Harrishao/mechanic-design/README.md

# 一个存作业的自用仓库，如果你误入了这里，那祝你每天都有好心情

# 希望明天也是个好天气
