Harrishao/mechanic-design/设计文档/说明书结构参考.md

# 封面

# 目录

# 第一章 机构运动原理

- 论述机构的原理和各机构工作时的运动流程
- 依据当前方案重绘 重建方案\参考图_整机布局.png 并插入此节

# 第二章 设计要求及机构选型

- 列出题目给出的设计要求，具体内容参照 机械原理课程设计任务书\1.机械原理课程设计任务书（15吨压片机）.doc ，包含具体数据
- 解析设计要求，分析如何设计机构以达到要求
- 讲解构型选择和数据确定的相关内容
- 论述最终确定三个凸轮串联在主轴上，由主轴直接驱动的方案的理由

# 第三章 机构综合

## 下冲头

- 描述下冲头的运动过程，包括具体参数
- 绘制下冲头位移运动循环图，插入
- 绘制下冲头运动简图，插入
- 描述据运动过程推导各构件参数的过程
- 由 凸轮廓线\下冲头凸轮.csv 拟合下凸轮廓线图，插入
- 插入下凸轮3d模型等轴测示意图 图表\下冲头凸轮-3d-等轴测.png
- 插入下冲头3d模型等轴测示意图 图表\下冲头-3d-等轴测.png

## 上冲头

- 描述下冲头的运动过程，包括具体参数
- 绘制下冲头位移运动循环图，插入
- 绘制下冲头运动简图，插入
- 描述据运动过程推导各构件参数的过程
- 由 凸轮廓线\上冲头凸轮v2.csv 拟合下凸轮廓线图，插入
- 插入上凸轮3d模型等轴测示意图 图表\上冲头凸轮-3d-等轴测.png
- 插入上冲头3d模型等轴测示意图 图表\上冲头-3d-等轴测.png

## 粉筛

- 描述与绘图同上
- 插入 图表\粉筛凸轮-3d-等轴测.png
- 插入 图表\粉筛托架-3d-等轴测.png

## 电机及减速器

- 描述根据电机参数选定 Y113m-6 电机的过程，其中提到电机模型来自 https://www.traceparts.com/en/product/hoyer-ie3-electric-motor-frame-size-112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 
- 描述推导减速器齿轮系所用齿轮及带轮参数的过程
- 绘制减速器主体齿轮的运动简图，插入
- 插入图表\电机及减速器-3d.png

## 第四章 整机装配

- 插入 图表\整机初相位-3d.png
- 根据当前数据重绘 图表\运动循环图_细化.png ，插入
- 并作配套说明

## 第五章 上冲头机构运动分析

- 参照 运动分析 目录下内容，其中机构运动简图使用机器绘制的而非手绘图

## 第六章 整机三维图

- 插入 图表\整机装配-3d-侧视.png
- 插入 图表\整机装配-3d-等轴测.png
