Harrishao/mechanic-design/待办事项2.md

# 现在的情况？

- 设计文档\15吨压片机设计计算说明书.docx 的排版和内容并不令人满意
- reference\15T压片机说明书.pdf 是一份好的说明书，以此为格式及内容的参照，重写说明书

# 我们的说明书？

- 结构见 设计文档\说明书结构参考.md

## 需要补充说明的？

- 运动简图的绘制原则：参考 reference\15T压片机说明书.pdf 中运动机构简图及手绘简图，确保所绘运动简图符合标准，如杆件抽象为直线，啮合齿轮简化为"工"字等
