Harrishao/mechanic-design/重建方案/变更_粉筛v4_销左端Y223.md

# 粉筛 v4 变更单：销在左端、销高回到 Y=223（取代 v3）

> 动机：v3 销高 250（高出主体中心 27）会引入俯仰力矩。v4 把销放回主体中心高 Y=223，
> 同时保留左端、Z=0 对中、双耳双剪的全部优点。
> 实现关键：连杆改为与销同高的**短水平连杆**（贴台面上方 5.5 掠过），摆杆连杆臂改为**长竖臂**，
> B 点近水平摆动——连杆既不下穿台面（v2 的 Z 偏置原因）也无需抬高销（v3 的原因）。
> 配套：参考图_托架视图_v4.png · 参考图_粉筛机构_v4.png · 粉筛凸轮v4_SW.txt / .csv · 粉筛v4_左端销223.py · 绘图v4.py

## 1. 不变项

托架本体与筛口、托架运动（−27~+28 / −75~−20，行程48）、运动循环、滚子 d20×15、Z=132.5 站位、上下冲头全部。

## 2. 构件清单（相对 v2 原始方案）

| 构件 | v4 值 |
|---|---|
| 托架 | 左端双耳叉：两耳板 27(X)×8(Z)×14(Y)，与本体同高（Y216~230），Z=±8~±16（内档16），端部R7；销孔 φ8 轴心距左端面 20、**Y=223（主体中心高）** |
| 销 | φ8×约40，沿 Z，双剪；装料位轴心 (−47, 223) |
| 连杆 | **Ls=36.03**（短水平连杆，运动平面 Z=0，距台面最小 5.5） |
| 摆杆 | 滚子臂 Lr=50（滚子沿用）；连杆臂 **Rb=190（竖直向上）**；两臂夹角 **153.91°**；摆角 14.51° |
| 机架支点 O2s | **(−107, 33)**，中心距 a=111.97 |
| 粉筛凸轮 v4 | **r0=80，实际廓线 70.0~82.0**（历版最小），宽20；廓线文件 粉筛凸轮v4_SW.txt |
| 台面 | 左缘 X=−80（窗口 −83~−76：竖臂过台面平面处 X=−83.7，托架支撑需到 −75）；台面上方 Y216~230、X −131~−47、Z±16 范围为连杆/B销运动空间，不得布置挡板或导轨凸起 |

## 3. 装配坐标（装料位 φ=0~90 → 左停位 φ=135~290）

| 点 | 装料位 | 左停位 |
|---|---|---|
| O2s（固定） | (−107, 33) | 同 |
| B 竖臂顶端 | (−83.00, 221.48) | (−131.00, 221.48) |
| C 托架销 | (−47, 223) | (−95, 223) |
| P 滚子中心 | (−90.86, −14.32)，距主轴 **91.98** | (−79.52, −8.77)，距主轴 **80.00**（基圆） |

摆杆方位（自 O2s）：连杆臂 装料 82.74° / 左停 97.26°；滚子臂 左停 −56.66°。

## 4. 校核

行程数值解 48.0000；推卸压力角 **26.4° ≤30°**，左退 37.6°（空程，弹簧力封闭）；最小曲率半径 36.3 ≫ 滚子10；传动角 min **80.3°**；连杆/B 销全程高于台面 5.5；竖臂穿台面平面处 X=−83.7，距台面左缘 3.7；滚子臂段距主轴最小 80 > 下冲头凸轮 64；耳板最右 X=−40 < −17，全程不入冲头区。凸轮为历版最小（实际最大 82.0；v2 89.1 / v3 96.4）。

## 5. 装配与相位

凸轮 v4 廓线按装料位（φ=0，全升程）姿态生成，按零件原始姿态装轴（基准面对齐法同前）。
复核值：**v4 远休弧中点方向 156.5°**（下冲头 145.3°、上冲头 107.8° 不变）。
静态验证：左停位滚子中心距主轴 80.00、销 X=−95；装料位 91.98、销 X=−47。力封闭弹簧保留（可挂竖臂与机架之间，水平拉向 +X）。

> v3（销高250）方案文件保留备查，建模请按本 v4 执行。
