Harrishao/mechanic-design/重建方案/重建数据_上冲头与粉筛.md

# 上冲头 / 粉筛机构 重建数据（v2）

> 配套文件（均在 `重建方案/` 内）：
> 参考图_上冲头机构.png · 参考图_粉筛机构.png · 参考图_凸轮工作图.png · 参考图_运动与压力角.png · 参考图_整机布局.png · 参考图_托架视图.png
> 上冲头凸轮v2_SW.txt / .csv · 粉筛凸轮v2_SW.txt / .csv · 计算脚本.py · 绘图脚本.py · 结果.json
> 所有数据由 计算脚本.py 解析计算并经数值反验（廓线-滚子接触偏差 < 0.001mm），单位 mm / 度。

---

## 0. 基准约定（与下冲头完全一致，不变）

- 凸轮回转中心 O1 = (0,0)，主轴沿 Z，**逆时针**回转（已从 下冲头凸轮_SW.txt 反推确认）
- φ = 0 为装填位；型腔轴线 X = 0；型腔顶面 Y = 216、底面 Y = 186（φ34×30，不变）
- 台面 Y = 216；下冲头机构、下冲头凸轮、型腔、运动循环中下冲头相位**全部不变**
- 凸轮轴向站位不变：下冲头中面 Z = 0 / 上冲头 Z = 67.5 / 粉筛 Z = 132.5；轮缘宽 25 / 30 / 20
- 滚子沿用现有件：上冲头滚子 d24×15、粉筛滚子 d20×15

## 1. 重建要点（相对旧方案的改变）

1. **上冲头改为二级摆杆增力布置**（按手绘方案页面下方画法）：凸轮 → 下摆杆（O2）→ 长连杆 → 上摆杆（O3，直杆杠杆，臂比 70:140 = 1:2）→ 小连杆 → 冲头。摆杆需求摆角由 30° 降到 18.2°，凸轮理论基圆由 **117 → 54**，实际廓线最大半径仅 68.9；冲头长度由 231 → **130**。
2. **粉筛同拓扑缩小**：中心距 170 → **109.7**，理论基圆 113.5 → **81**，实际廓线最大半径 89.1（旧方案仅基圆就 113.5）；连杆 250 → 211.7。托架、筛口、耳板销位**不变**（销 Y=223，行程仍 48，装料位销 X=+42、筛口中心对正 X=0）。
3. **粉筛左退窗口由 90~120° 放宽到 90~135°**，以压低左退压力角。校核依据：上冲头尖端在 φ≈170° 才降到托架顶面高度（Y≈230），φ=135 退净仍有 35° 裕量；其余相位不动。⚠ 需同步更新 运动循环图 与运动方案文档中粉筛一行。
4. 两机构全部杆系位于 XY 平面（Z≈0 薄层），仅滚子沿 Z 悬臂伸至各自凸轮站位（沿用现有"z轴避让"做法）；**粉筛连杆与托架耳板置于 Z≈+45 平面**（托架前缘侧），与冲头错开。
5. 旧 整机装配参数填写表.md 中上冲头、粉筛两节作废，以本文档为准。

## 2. 运动循环（重建后，主轴转角 φ，25 r/min）

| φ (°) | 0–90 | 90–120 | 120–135 | 135–200 | 200–240 | 240–290 | 290–335 | 335–360 |
|---|---|---|---|---|---|---|---|---|
| 上冲头(尖端Y) | 300 停 | 300 停 | 300 停(至120) | 120–200 摆线下压至 205 | 205 保压 | 摆线回 300 | 300 停 | 300 停 |
| 下冲头 | 不变 | 下沉 | 复位+预压(不变) | 不变 | 保压(不变) | 顶出(不变) | 停(不变) | 复位(不变) |
| 粉筛(销X) | +42 停(筛料) | 90–135 摆线左退至 −6 | ← | −6 停 | −6 停 | −6 停 | 摆线右移推卸至 +42 | +42 停 |

位移过渡均为摆线（等同旧方案），凸轮廓线即按上表生成。

## 3. 上冲头机构（建模数据）

### 3.1 机构简述

凸轮（O1）推下摆杆（支点 O2，滚子臂 Lr、连杆臂 LB）；B 点经长连杆 L1 上传至上摆杆 D 端；上摆杆为**直杆杠杆**（支点 O3，D 臂 70 / C 臂 140，两臂反向共线）；C 端经小连杆 L2 下挂冲头销 E；冲头沿 X=0 竖直导向。压程中凸轮升程将冲头压下，行程精确 95。

### 3.2 构件尺寸

| 构件 | 参数 | 数值 |
|---|---|---|
| 凸轮 v2 | 理论基圆 r0 / 实际廓线半径 / 轮缘宽 / 孔径 | 54 / 42.0~68.9 / 30 / φ20 |
| 滚子（沿用） | 直径 × 宽 | d24 × 15 |
| 下摆杆 | 滚子臂 Lr / 连杆臂 LB / 两臂夹角 / 摆角 | 85 / 150 / 121.28° / 18.218° |
| 长连杆 | 孔心距 L1 | **423.93** |
| 上摆杆（直杆） | D 臂 R3 / C 臂 R3p（反向共线，总长 210）/ 总转角 | 70 / 140 / 39.67° |
| 小连杆 | 孔心距 L2 | 75 |
| 上冲头 | 销 E→尖端 Lp / 工作端 / 导向段 | **130** / φ34×45 / φ40×85 |

### 3.3 装配坐标（装填位 φ=0 → 保压位 φ=200~240）

| 点 | 装填位 (X,Y) | 保压位 (X,Y) | 说明 |
|---|---|---|---|
| O1 | (0, 0) | 同 | 主轴，固定 |
| O2 | (100, 35) | 同 | 下摆杆支点，固定，机架 |
| O3 | (140, 457.04) | 同 | 上摆杆支点，固定，机架 |
| P 滚子中心 | (45.02, −29.82) | (68.04, −43.76) | 装填位方位角 −33.5° |
| B | (248.14, 11.47) | (248.07, 58.97) | 下摆杆连杆臂端 |
| D | (205.85, 433.29) | (205.85, 480.79) | 上摆杆短臂端 |
| C | (8.30, 504.54) | (8.30, 409.54) | 上摆杆长臂端 |
| E 冲头销 | (0, 430.00) | (0, 335.00) | 冲头尖端 = E_y − 130 |
| 冲头尖端 | (0, 300.00) | (0, 205.00) | 行程 95.000 |

导向套建议：φ40 内孔，沿 X=0 布置在 Y ≈ 308~358（保压位仍有 ≥27 导向长度）。
下摆杆装填位姿态：连杆臂方位 −9.02°、滚子臂方位 −130.30°（自 O2，从 +X 轴逆时针计）。

### 3.4 校核结果

- 压力角：压程（120~200°）max = **29.9° ≤ 30°**；回程（240~290°，空程）max = 44.0°（建议在 E 或 D 处加复位拉簧力封闭，弹簧只需克服构件自重与摩擦）
- 传动角：长连杆-下摆杆 min 75.3°，长连杆-上摆杆 min 64.4°；小连杆最大偏摆 6.4°（冲头侧向力 ≤ tan6.4° ≈ 11% 压力，可接受）
- 节曲线最小曲率半径 23.0 > 滚子半径 12，无根切
- 行程数值解 95.0000；保压段（200~240°）冲头位移恒为 95，与下冲头保压相位完全重合

## 4. 粉筛机构（建模数据）

### 4.1 机构简述

凸轮（O1）推摆杆（支点 O2s，滚子臂 50、连杆臂 110）；B 点经连杆 Ls 推托架销 C 沿台面（Y=216）水平滑动。基圆段对应左停位；升程（推卸 290~335°）凸轮主动推托架右移推走药片并回到装料位，受力方向合理。

### 4.2 构件尺寸

| 构件 | 参数 | 数值 |
|---|---|---|
| 凸轮 v2 | 理论基圆 r0 / 实际廓线半径 / 轮缘宽 / 孔径 | 81 / 71.0~89.1 / 20 / φ20 |
| 滚子（沿用） | 直径 × 宽 | d20 × 15 |
| 摆杆 | 滚子臂 Lr / 连杆臂 Rb / 两臂夹角 / 摆角 | 50 / 110 / 129.77° / 21.132° |
| 连杆 | 孔心距 Ls | **211.71** |
| 托架（不变） | 长×宽×厚 / 筛口 / 销孔位 | 55×60×14 / 36×40 / 销Y=223 |

### 4.3 装配坐标（装料位 φ=0~90 → 左停位 φ=135~290）

| 点 | 装料位 (X,Y) | 左停位 (X,Y) | 说明 |
|---|---|---|---|
| O2s | (−100, −45) | 同 | 摆杆支点，固定，中心距 a=109.66 |
| P 滚子中心 | (−61.88, −77.36) | (−52.78, −61.44) | 装料位=全升程，方位角 −128.7° |
| B | (−98.91, 64.99) | (−138.64, 57.99) | 摆杆连杆臂端 |
| C 托架销 | (42, 223) | (−6, 223) | 行程 48.000；装料位筛口中心 X=0 |

摆杆姿态（自 O2s，从 +X 轴逆时针计）：连杆臂方位 装料位 89.43° / 左停位 110.57°；滚子臂方位 左停位 −19.20°。

### 4.4 校核结果

- 压力角：推卸（工作行程，290~335°）max = **20.8° ≤ 30°**；左退（90~135°，空程）max = 37.0°（弹簧力封闭即可；左退窗口已由 30° 放宽到 45°，否则此值 >55°）
- 传动角：连杆-摆杆 min 41.2°；连杆与水平最大夹角 51.2°（与旧方案 44.5° 相当）
- 节曲线最小曲率半径 34.4 > 滚子半径 10，无根切
- 左停位连杆到主轴最小距离 144.4 > 凸轮最大半径 89.1，无干涉

### 4.5 托架细化尺寸（见 参考图_托架视图.png，装料位基准）

| 要素 | 尺寸 / 位置（装料位） |
|---|---|
| 本体 | 55(X) × 60(Z) × 14(Y)；X −27~+28，Y 216~230，Z −30~+30；前缘(推卸缘) X=+28 |
| 筛口 | 36(X) × 40(Z) 上下通孔；X −18~+18（中心正对型腔 X=0），Z −20~+20；距前缘 10、距后缘 9、Z 向两侧各留 10 |
| 耳板 | 厚 8 平板，平行 XY 平面，Z +41~+49（中面 +45 = 连杆运动平面）；X +8~+49，高 14（Y 216~230），端部 R7 圆头 |
| 连接颈 | 20(X) × 14(Y) × 11(Z)；X +8~+28，Z +30~+41，连接本体前面与耳板 |
| 销孔 | φ8 通孔，轴线沿 Z，轴心 (42, 223)（距下表面 +7 / 距上表面 −7） |
| 位置 | 装料位销 X=+42（φ=0~90°）；左停位整体左移 48，销 X=−6（φ=135~290°） |

## 5. 凸轮廓线文件与安装相位

1. `上冲头凸轮v2_SW.txt`、`粉筛凸轮v2_SW.txt` 为**实际廓线**（已扣滚子半径），格式与 下冲头凸轮_SW.txt 相同（x TAB y TAB 0，闭合，720 点），SolidWorks「通过 XYZ 点的曲线」直接导入后拉伸。
2. 廓线在**真实机构坐标系**中生成：文件姿态即装填位（φ=0）姿态。装配时把主轴置于装填位（下冲头装填位、上冲头最高、粉筛在装料位），三凸轮**按文件原始姿态装上即可，无需再旋转**（即"装填位对齐法"，旧表中 0°/128°/201° 的数值安装角作废）。
3. 校对基准：装填位时上冲头凸轮滚子中心应在方位角 −33.5°、半径 54 处；粉筛凸轮滚子中心在方位角 −128.7°、半径 99.07 处（粉筛装填位为全升程）。
4. `.csv` 含 φ、摆角 ψ、节曲线半径、实际廓线半径、压力角，可用于说明书运动分析章节。

## 6. 建模与装配顺序建议

1. 按 §3.2 / §4.2 建摆杆、连杆、上摆杆（直杆）、缩短后的上冲头；凸轮由 txt 导入拉伸（宽 30 / 20，孔 φ20 + 键槽）。
2. 摆杆滚子臂照旧做 z 向避让：滚子悬臂伸至各自凸轮中面（上冲头 Z=67.5、粉筛 Z=132.5），杆系本体留在 Z≈0 薄层；粉筛连杆与托架耳板在 Z≈+45 平面。
3. 机架需新增三个固定支点：O2(100,35)、O3(140,457.04)、O2s(−100,−45)，及 X=0、Y≈308~358 的冲头导向套。
4. 台面右缘控制在 X ≤ 180（上冲头长连杆运动区 X≈206~248）；左缘照旧给托架让位。
5. 铰点销径沿用现有 d8 / d20 销件体系。
6. 上冲头、粉筛各加一根复位拉簧（力封闭），分别挂在 E/D 附近与摆杆连杆臂上。

## 7. 需同步更新的旧文档

- [ ] 运动循环图（细化）：粉筛左退 90~120 → **90~135**
- [ ] 15吨压片机整机运动方案.docx 粉筛一行同上
- [ ] 整机装配参数填写表.md：§1 安装相位、§3 上冲头、§4 粉筛 作废，改引本文档
- [ ] 删除旧版上冲头摆杆 v1/v2/v3、旧上冲头凸轮、旧粉筛凸轮等模型，避免误用
