Harrishao/mechanic-design/归档_旧版/变更_粉筛v3_销移左端.md

# 粉筛 v3 变更单：托架销移至左端（取代 v2 粉筛部分）

> 动机：v2 耳板悬于前侧（Z=+45）单耳受力且不美观。销移到左端后耳板全程不进入冲头区
> （销最右仅 X=−47 < −17），因此可放回托架中线 Z=0 并做成双耳夹叉——受力过质心、销双剪。
> 配套文件：参考图_托架视图_v3.png · 参考图_粉筛机构_v3.png · 粉筛凸轮v3_SW.txt / .csv · 粉筛v3_左端销.py · 绘图v3.py

## 1. 不变项

托架本体（55×60×14、筛口36×40 及其留边）、托架运动（位置 −27~+28 / −75~−20、行程48、装料位筛口对型腔）、运动循环相位、滚子 d20×15、凸轮轴向站位 Z=132.5、上冲头与下冲头全部。

## 2. 需同步修改的构件（共 6 项）

| 构件 | 改动 | 新值 |
|---|---|---|
| 托架 | 删除右前侧耳板+连接颈；左端加双耳夹叉 | 双耳板 27(X)×8(Z)×39(Y 218~257)，Z=±8~±16（内档16），销孔 φ8 轴心距左端面 20、Y=250，端部 R7；耳板底 Y=218（高出台面2） |
| 销 | 移位并加长（双剪） | φ8×约40，轴线沿 Z，轴心装料位 (−47, 250) |
| 连杆 | 重做（缩短），端头入叉口 | 孔距 **Ls=170.56**，端头厚 ≤14 |
| 摆杆 | 臂长不变、夹角改 → 新零件 | Lr=50 / Rb=110 不变；两臂夹角 **151.36°**（原129.77°）；摆角 17.58° |
| 机架支点 O2s | 移位 | **(−113, 52)**（原 (−100,−45)），中心距 a=124.39 |
| 粉筛凸轮 | 重新生成 v3 | r0=92，实际廓线 82.0~96.4，宽20；导入 粉筛凸轮v3_SW.txt |

另：台面左缘收至 **X=−80**（区间 −86~−76 均可：≥−76 保证托架支撑到 −75，≤−86 之前连杆不穿台面，全行程连杆穿 Y=216 平面最右点为 −87.8）。v2 文档中"粉筛连杆位于 Z≈+45 平面"的注记作废，连杆运动平面改为 **Z=0**。

## 3. 装配坐标（装料位 φ=0~90 → 左停位 φ=135~290）

| 点 | 装料位 | 左停位 |
|---|---|---|
| O2s（固定） | (−113, 52) | 同 |
| B 连杆臂端 | (−177.98, 140.75) | (−201.75, 116.98) |
| C 托架销 | (−47, 250) | (−95, 250) |
| P 滚子中心 | (−106.42, 2.44)，距主轴 99·07→**106.44** | (−91.75, 6.74)，距主轴 **92.00**（基圆） |

摆杆方位（自 O2s）：连杆臂 装料 126.21° / 左停 143.79°；滚子臂 左停 −64.85°。

## 4. 校核

行程数值解 48.0000；推卸压力角 max **28.7° ≤30°**，左退 39.3°（空程，弹簧力封闭）；节曲线最小曲率半径 40.9 ≫ 滚子10；连杆-摆杆传动角 min **86.4°**（v2 为 41.2°，大幅改善）；滚子臂段距主轴最小 92 > 下冲头凸轮最大半径 64；耳板/销全程 X ≤ −40，不进入冲头区（±17）。代价：凸轮略增大（实际最大 96.4，v2 为 89.1）。

## 5. 装配与相位

凸轮 v3 廓线仍按真实坐标、装料位（φ=0，全升程）姿态生成：按零件原始姿态装轴即可（基准面对齐法同前）。复核值更新：**v3 远休弧中点方向 146.2°**（替代 v2 的 198.8°；下冲头 145.3°、上冲头 107.8° 不变），即「粉筛(v3)远休中点 − 下冲头远休中点 = +0.9°」。静态验证：左停位滚子中心距主轴 92.00、销 X=−95；装料位 106.44、销 X=−47。力封闭弹簧保留。
