Harrishao/mechanic-design/交付用/图表/下冲头-3d-等轴测.png

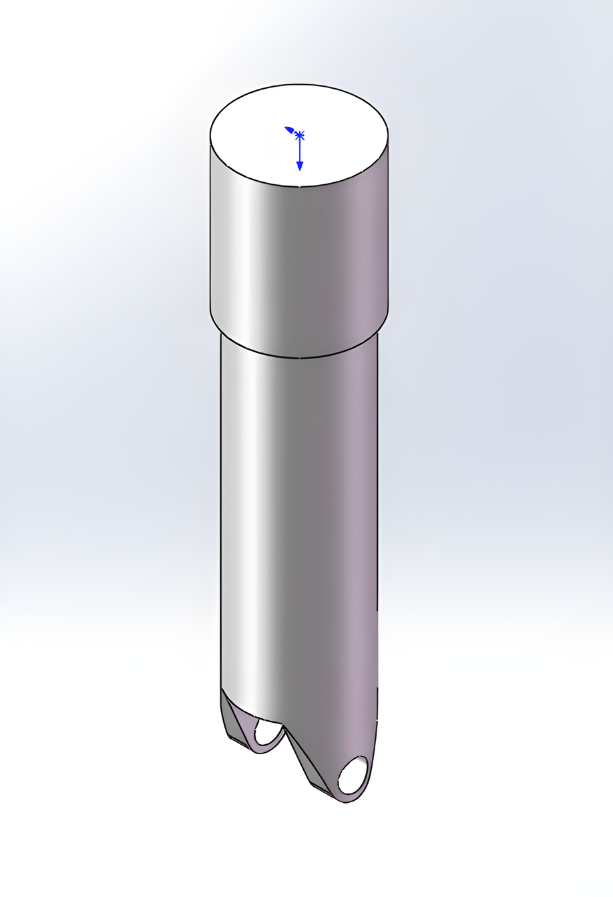
交付用/图表/下冲头-3d-等轴测.png
