Harrishao/mechanic-design/交付用/图表/廓线_上冲头.png

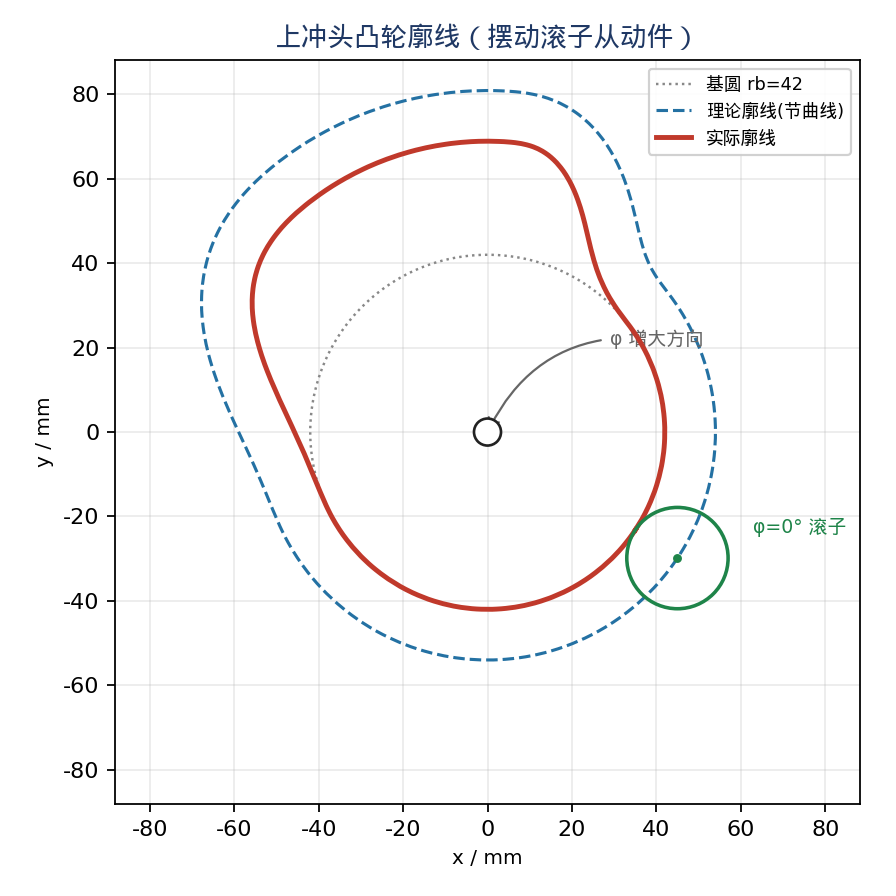
交付用/图表/廓线_上冲头.png
