Harrishao/mechanic-design/交付用/图表/廓线_下冲头.png

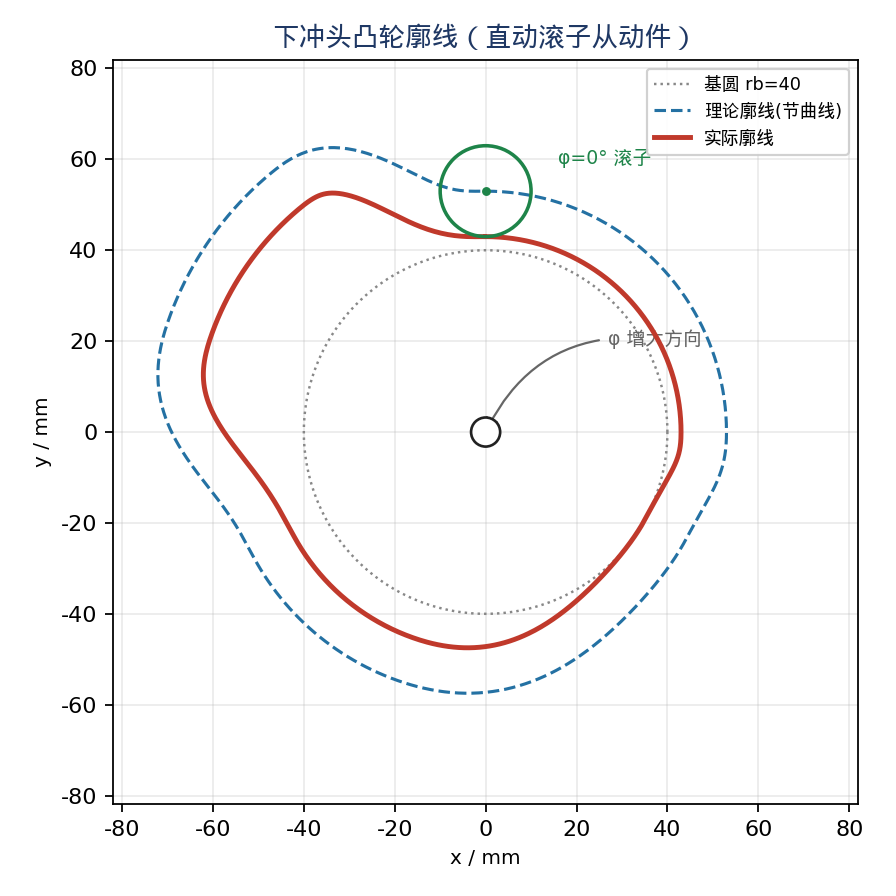
交付用/图表/廓线_下冲头.png
