Harrishao/mechanic-design/交付用/图表/廓线_粉筛.png

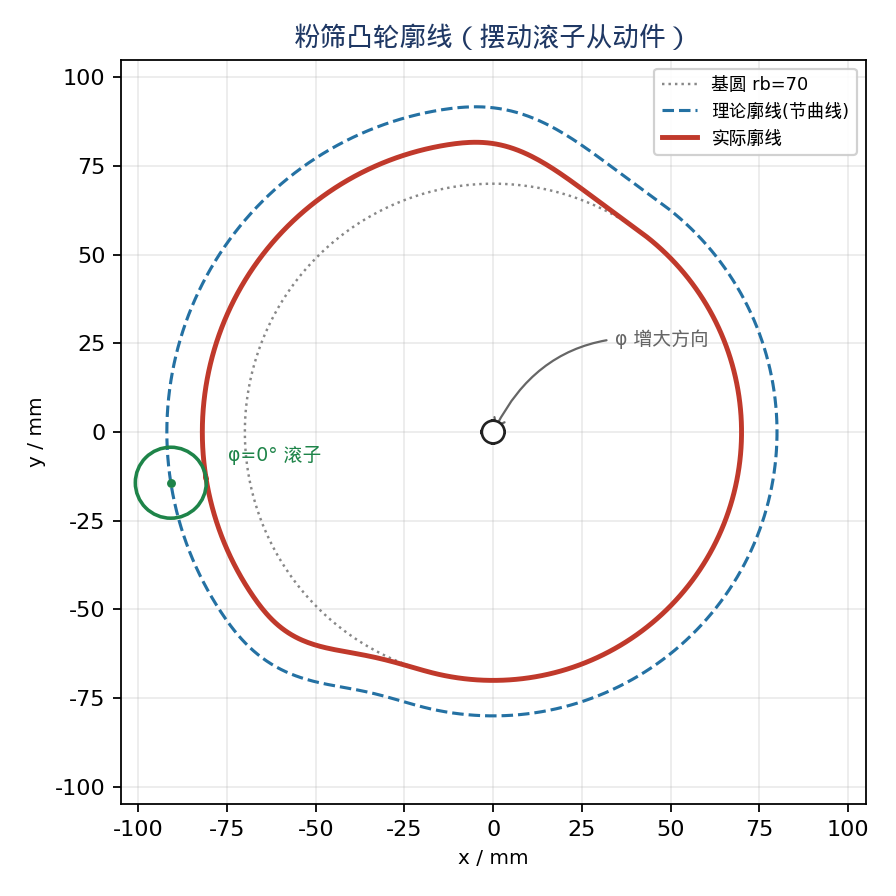
交付用/图表/廓线_粉筛.png
