Harrishao/mechanic-design/交付用/图表/循环_上冲头.png

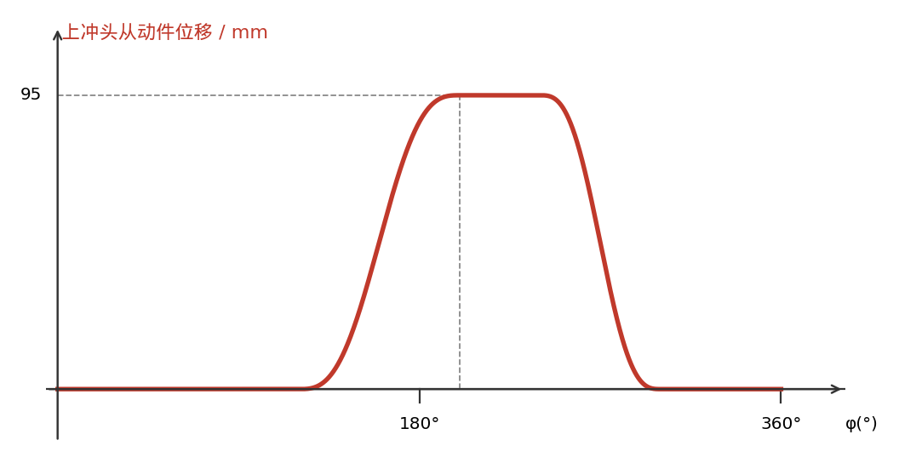
交付用/图表/循环_上冲头.png
