Harrishao/mechanic-design/交付用/图表/循环_下冲头.png

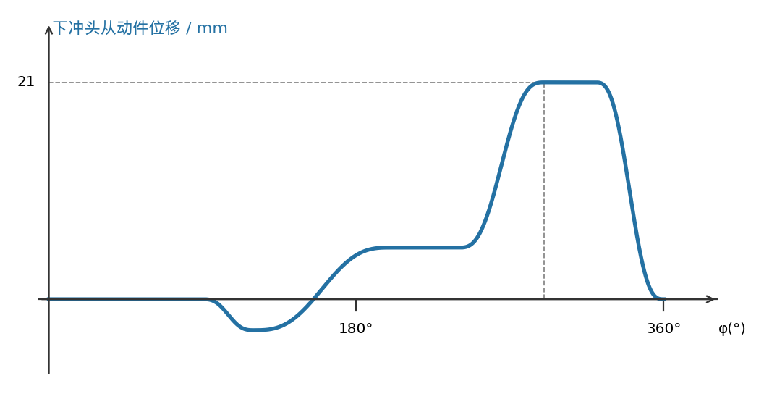
交付用/图表/循环_下冲头.png
