Harrishao/mechanic-design/交付用/图表/循环_粉筛.png

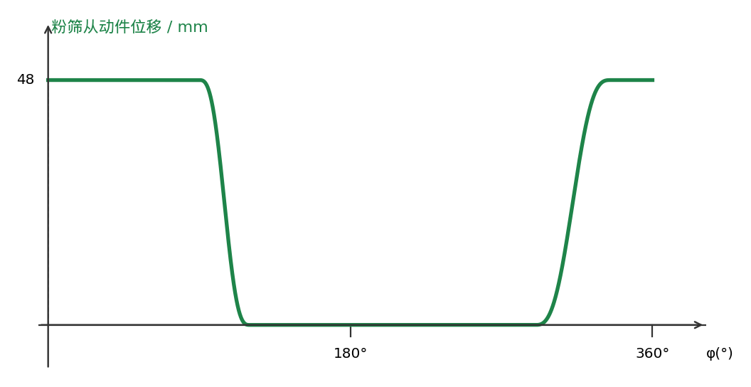
交付用/图表/循环_粉筛.png
