Harrishao/mechanic-design/交付用/图表/整机初相位-3d.png

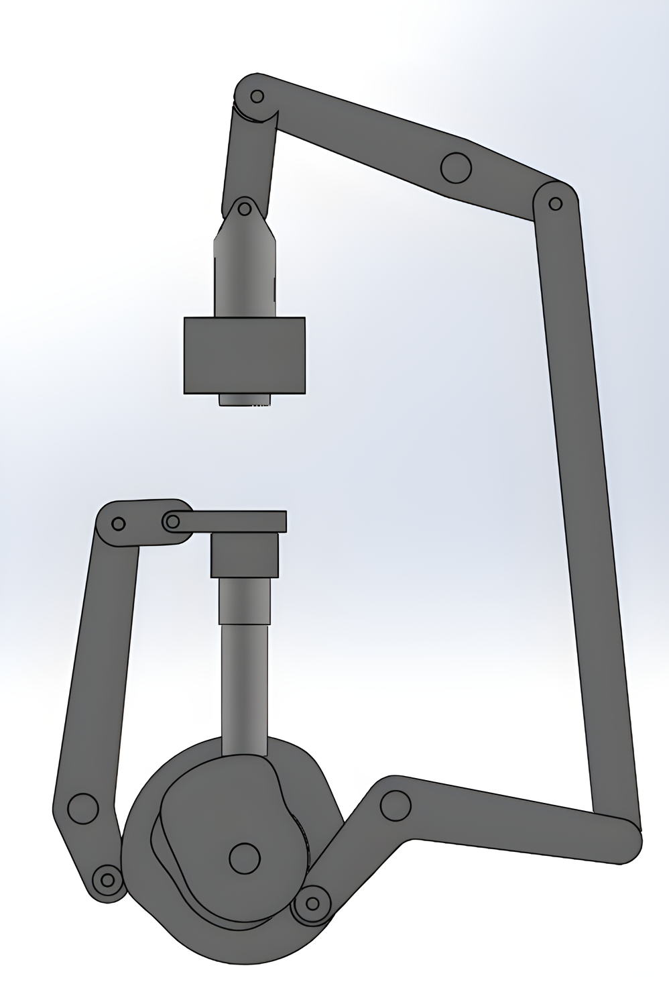
交付用/图表/整机初相位-3d.png
