Harrishao/mechanic-design/交付用/图表/整机机构运动简图.png

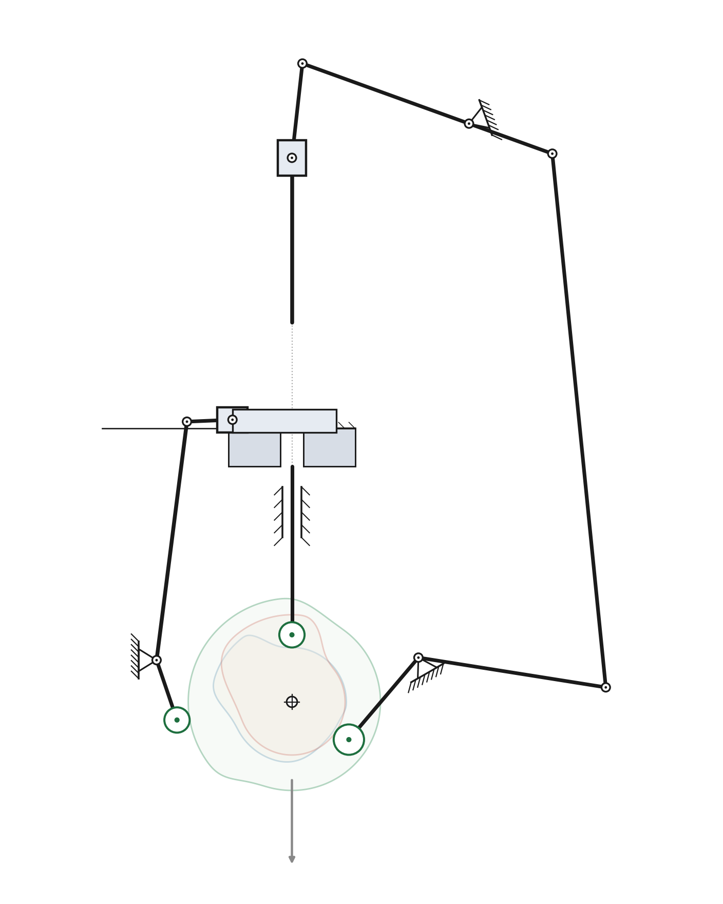
交付用/图表/整机机构运动简图.png
