Harrishao/mechanic-design/交付用/图表/电机及减速器-3d.png

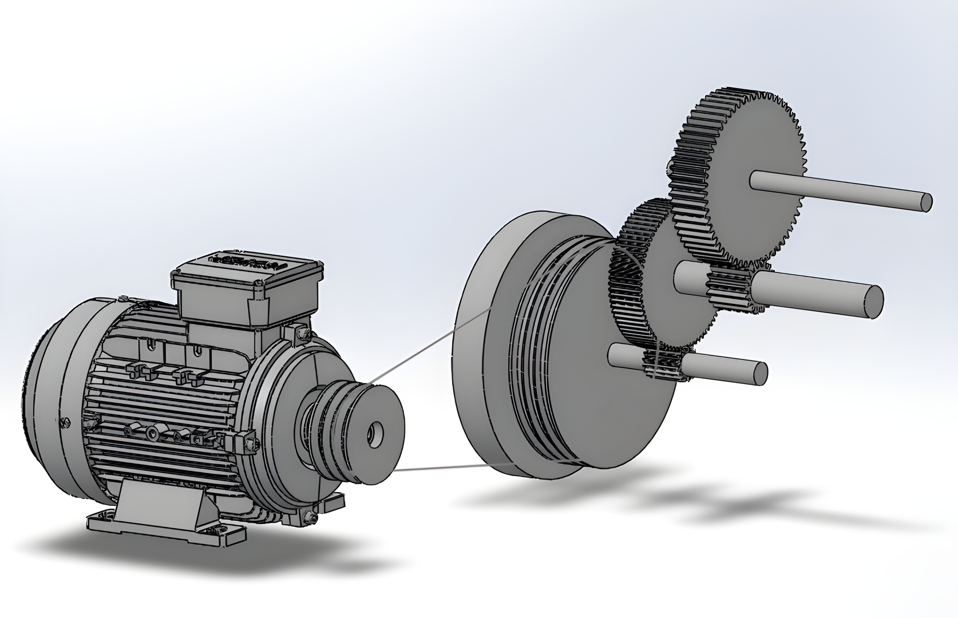
交付用/图表/电机及减速器-3d.png
