Harrishao/mechanic-design/交付用/图表/简图_上冲头.png

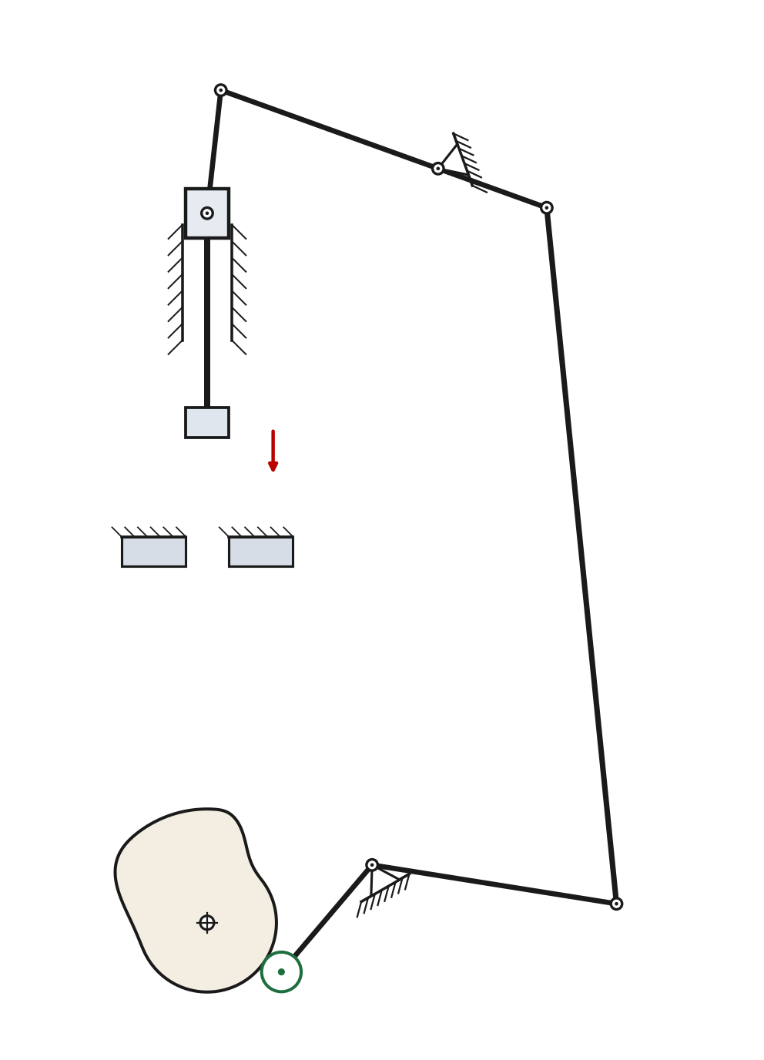
交付用/图表/简图_上冲头.png
