Harrishao/mechanic-design/交付用/图表/简图_减速器.png

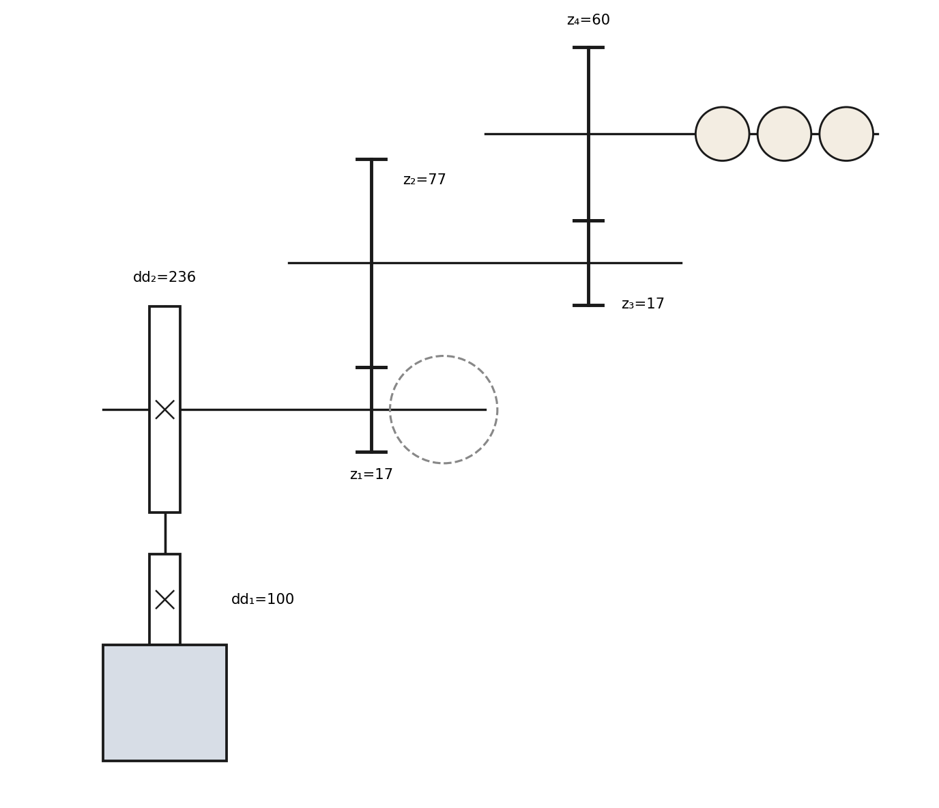
交付用/图表/简图_减速器.png
