Harrishao/mechanic-design/交付用/图表/简图_粉筛.png

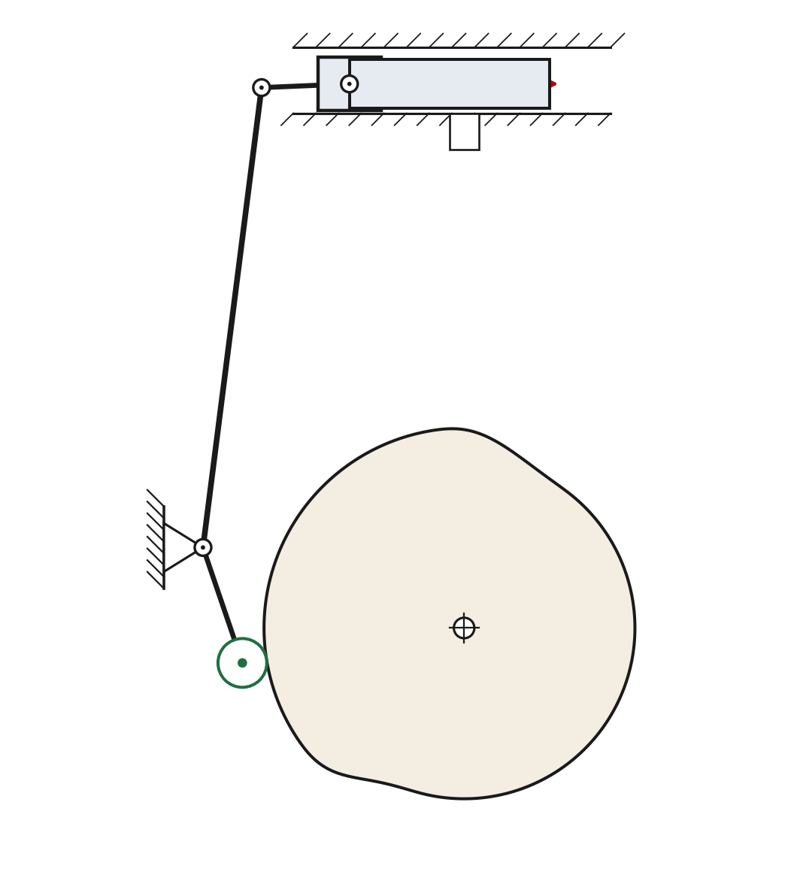
交付用/图表/简图_粉筛.png
