Harrishao/mechanic-design/交付用/图表/粉筛托架-3d-等轴测.png

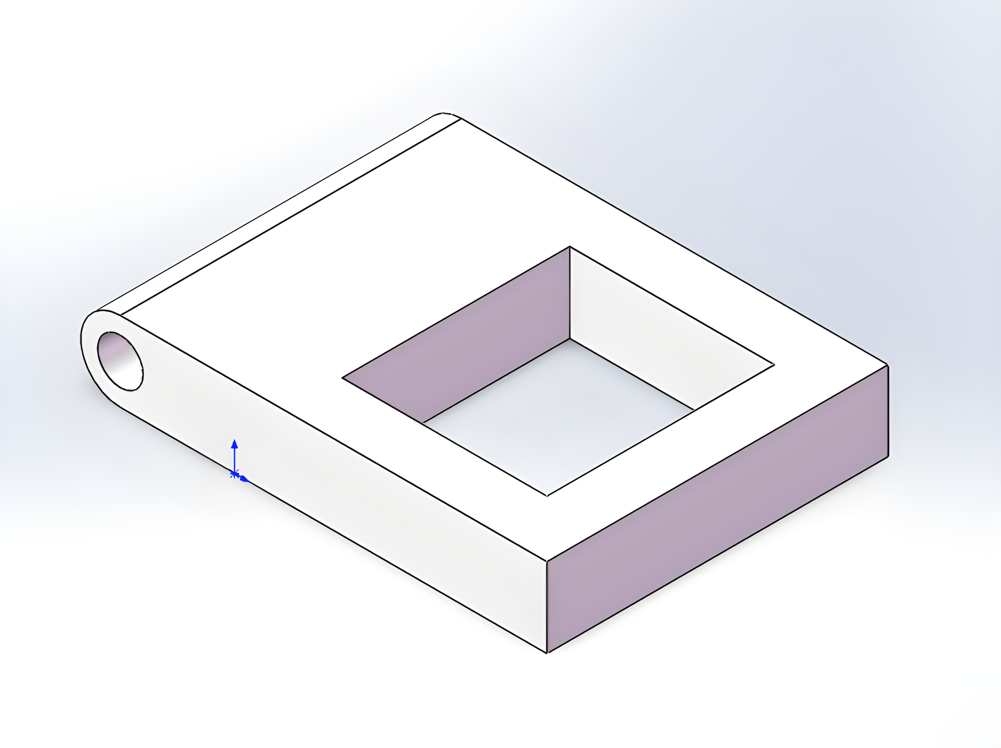
交付用/图表/粉筛托架-3d-等轴测.png
