Harrishao/mechanic-design/图表/新图_待审阅/审阅_运动简图组.jpg

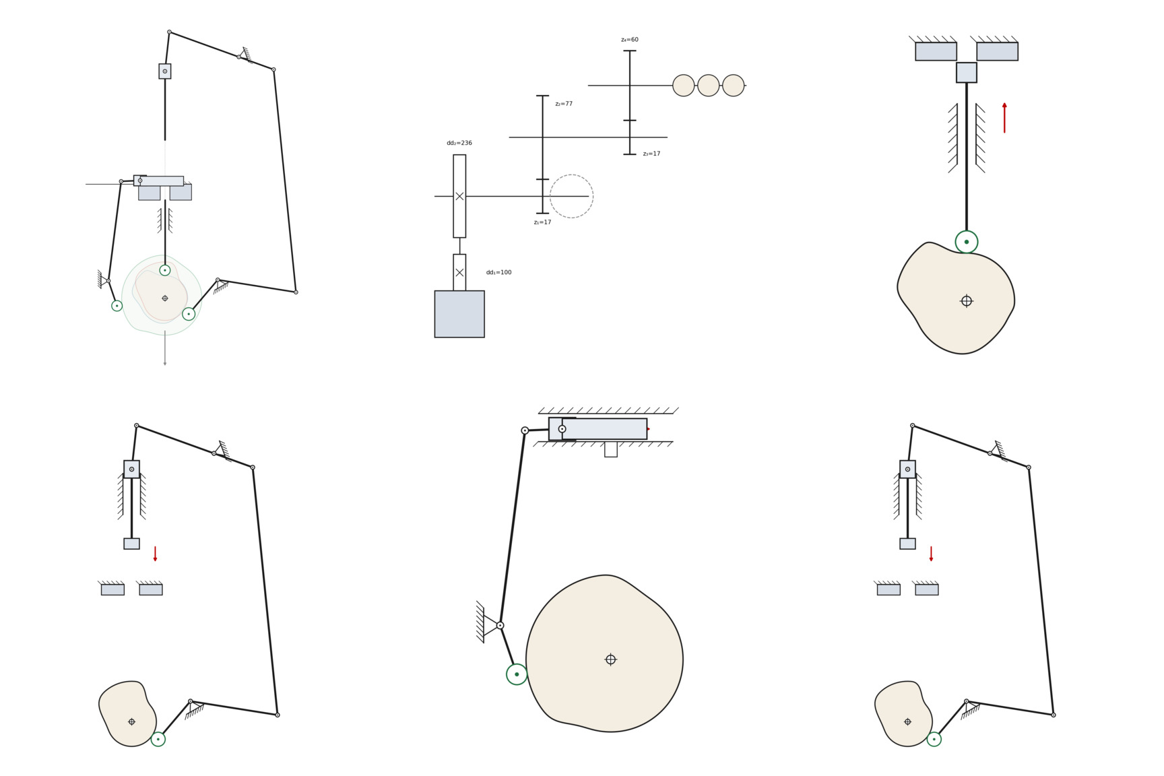
图表/新图_待审阅/审阅_运动简图组.jpg
