Harrishao/mechanic-design/三维模型/整机装配v2.SLDASM

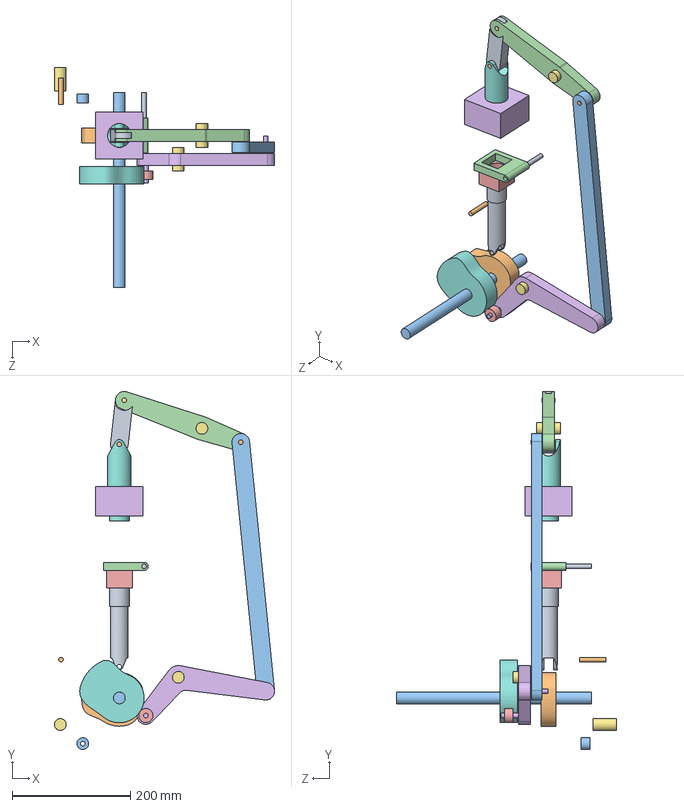
[picture p38: CAD file, 2026-06-12]
三维模型/整机装配v2.SLDASM
373.1 x 606.8 x 372.5 mm
主轴
下冲头凸轮
下冲头
上冲头凸轮v2
d20销 x 3
上冲头下摆杆v2
上冲头滚子
上冲头上摆杆v2
上冲头长连杆v2
d8销l40 x 2
上冲头短连杆v2
上冲头v2
d8销l22
导向套
型腔
粉筛托架
粉筛滚子
d8销l45
d8销l80
