Harrishao/mechanic-design/交付用/三维模型/上冲头-运动分析.SLDASM

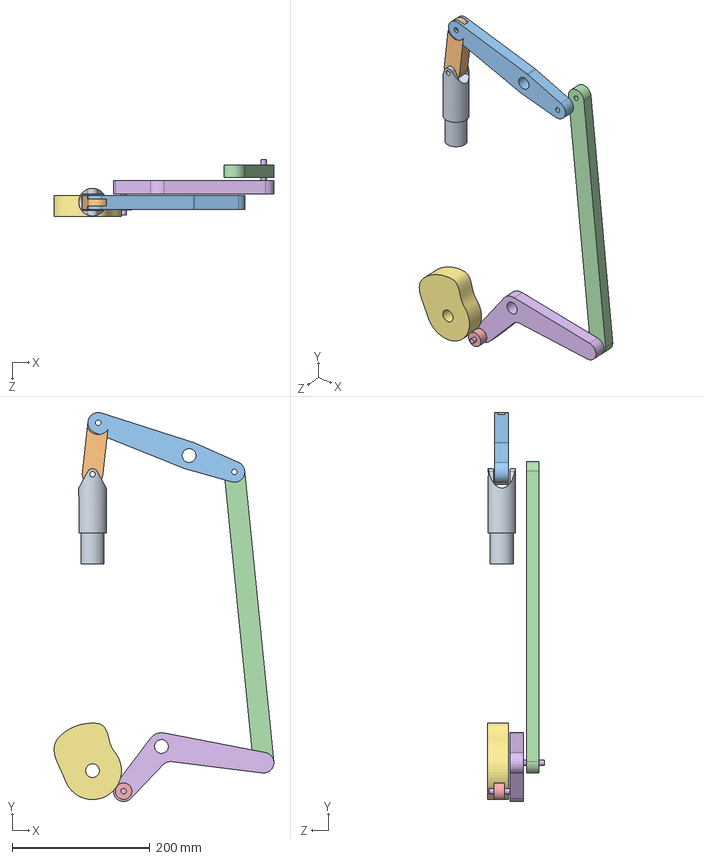
[picture p39: CAD file, 2026-06-14]
交付用/三维模型/上冲头-运动分析.SLDASM
318.8 x 564.2 x 82.0 mm
上冲头凸轮v2
上冲头下摆杆v2
上冲头滚子
上冲头长连杆v2
上冲头上摆杆v2
上冲头短连杆v2
上冲头v2
