Harrishao/mechanic-design/三维模型/上冲头装配.SLDASM

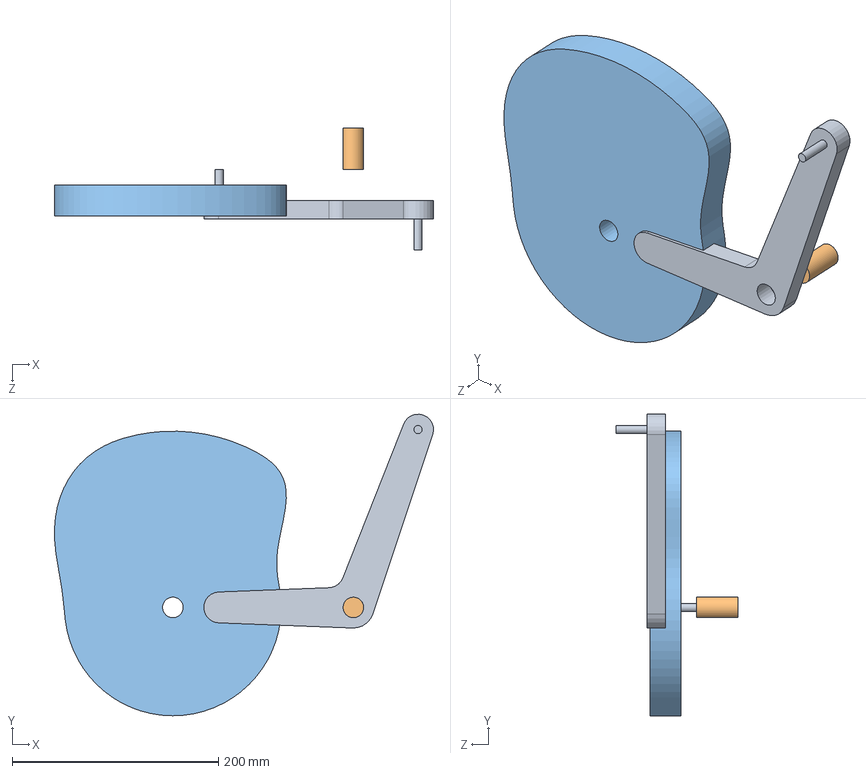
[picture p40: CAD file, 2026-06-11]
三维模型/上冲头装配.SLDASM
367.5 x 292.5 x 118.0 mm
上冲头凸轮
d20销
上冲头摆杆-z轴避让fix
