Harrishao/mechanic-design/交付用/三维模型/下冲头装配.SLDASM

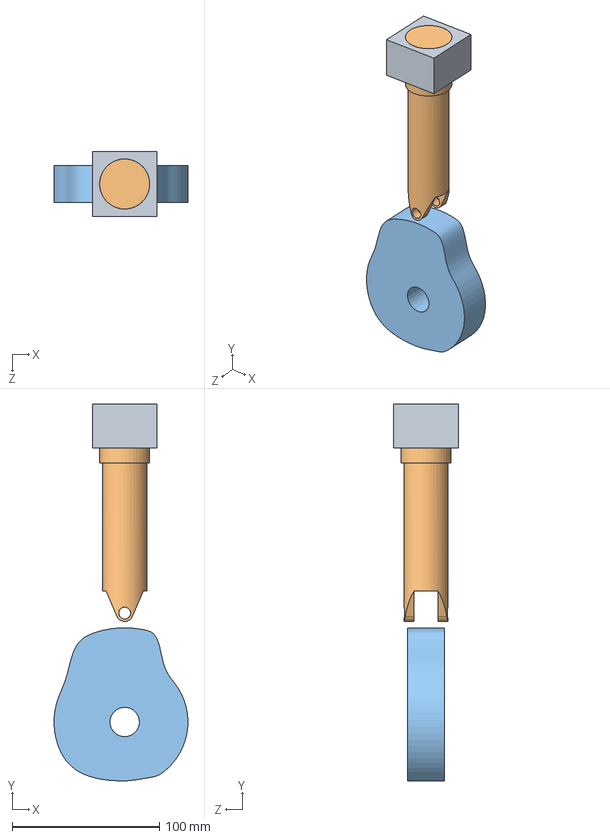
[picture p41: CAD file, 2026-06-11]
交付用/三维模型/下冲头装配.SLDASM
90.9 x 256.1 x 44.0 mm
下冲头凸轮
下冲头
型腔
