Harrishao/mechanic-design/三维模型/粉筛摆杆v3.SLDPRT

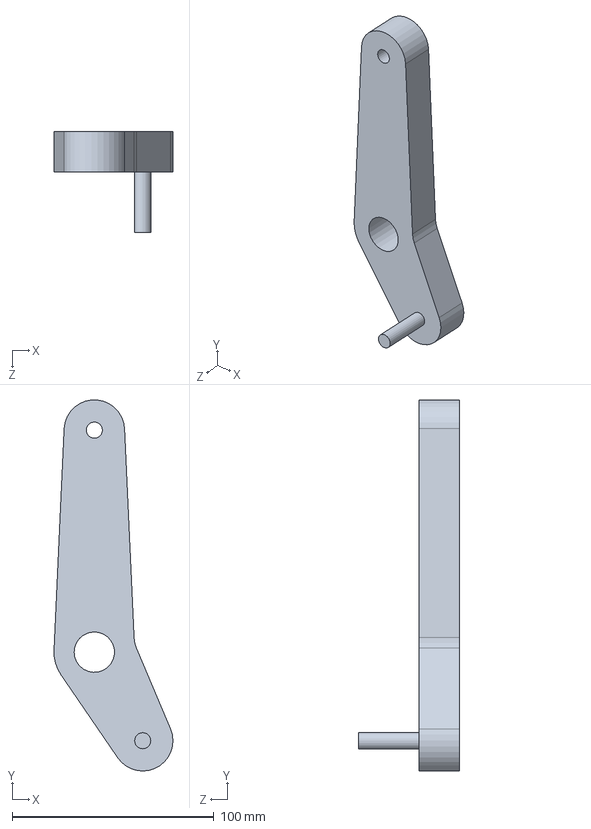
[picture p42: CAD file, 2026-06-12]
三维模型/粉筛摆杆v3.SLDPRT
58.9 x 183.8 x 50.0 mm
