Harrishao/mechanic-design/三维模型/粉筛凸轮v3.SLDPRT

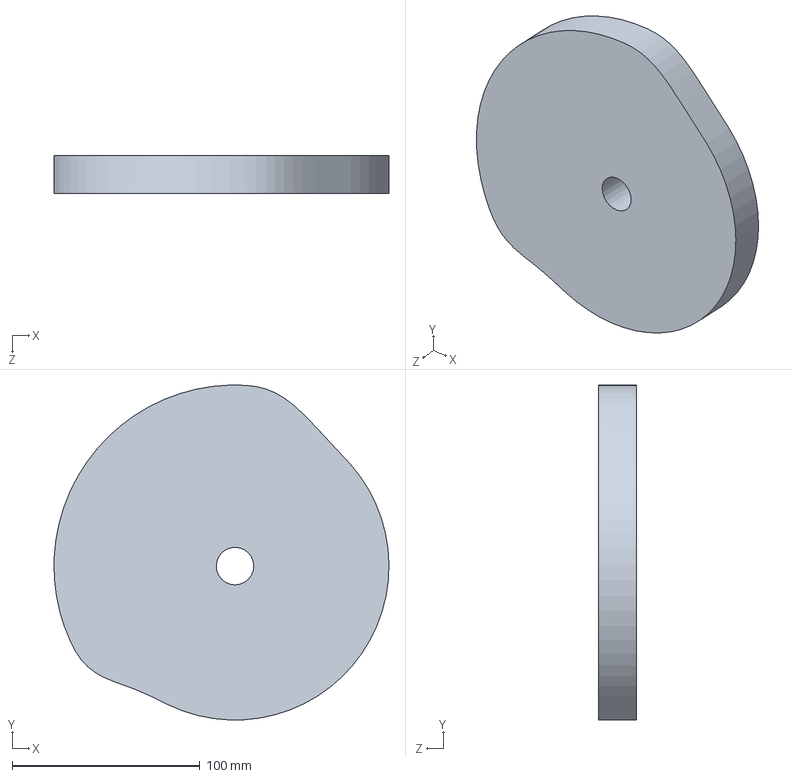
[picture p43: CAD file, 2026-06-12]
三维模型/粉筛凸轮v3.SLDPRT
178.4 x 178.3 x 20.0 mm
