Harrishao/mechanic-design/交付用/三维模型/上冲头上摆杆v2.SLDPRT

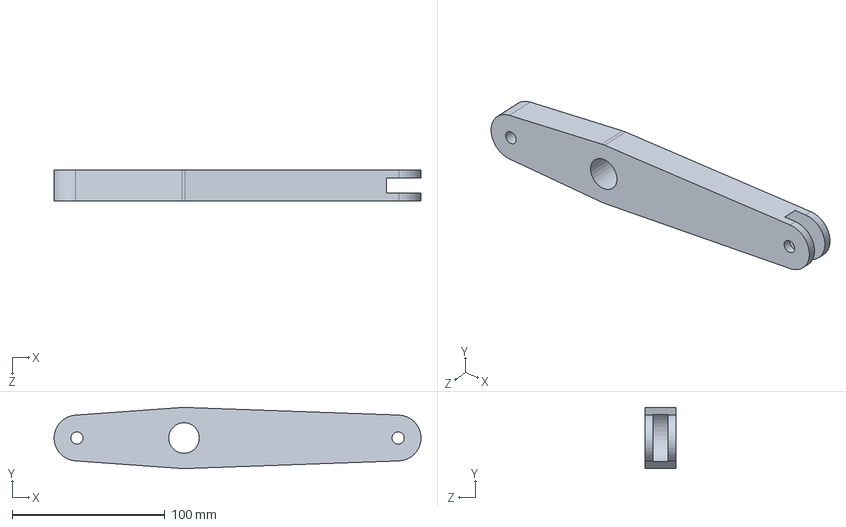
[picture p44: CAD file, 2026-06-20]
交付用/三维模型/上冲头上摆杆v2.SLDPRT
239.9 x 40.0 x 20.0 mm
