Harrishao/mechanic-design/三维模型/粉筛连杆v3.SLDPRT

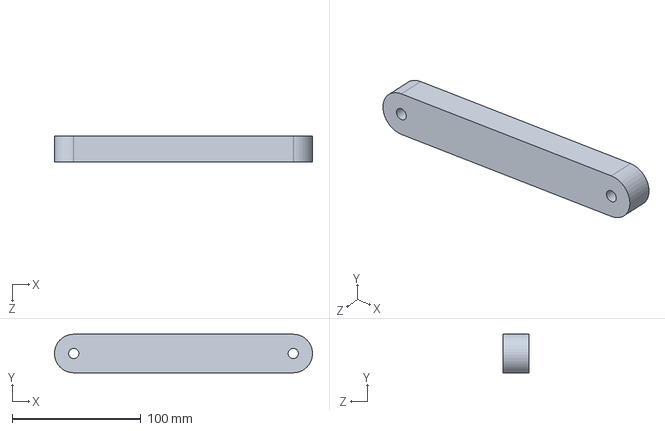
[picture p45: CAD file, 2026-06-12]
三维模型/粉筛连杆v3.SLDPRT
200.5 x 30.0 x 20.0 mm
