Harrishao/mechanic-design/交付用/三维模型/下冲头凸轮.SLDPRT

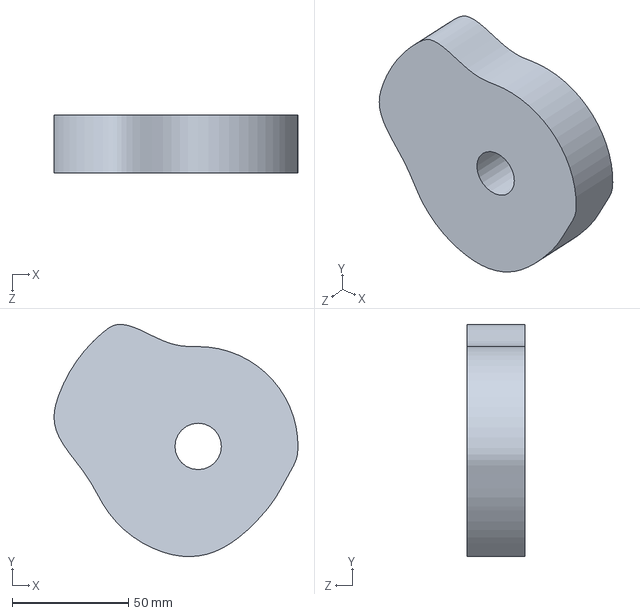
[picture p46: CAD file, 2026-06-20]
交付用/三维模型/下冲头凸轮.SLDPRT
105.1 x 100.0 x 25.0 mm
