Harrishao/mechanic-design/交付用/三维模型/d35传动轴.SLDPRT

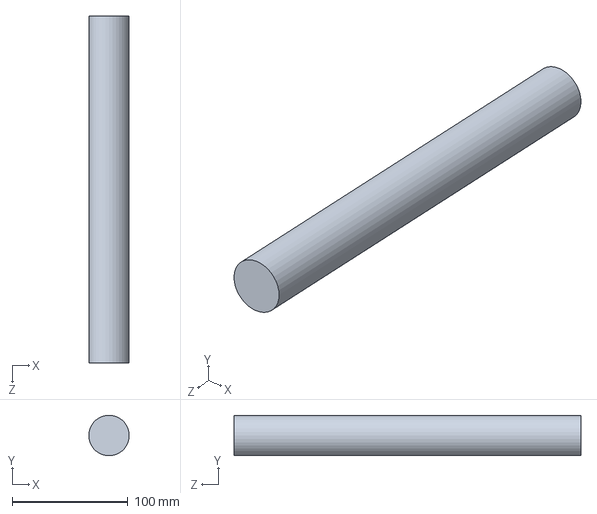
[picture p47: CAD file, 2026-06-14]
交付用/三维模型/d35传动轴.SLDPRT
35.0 x 35.0 x 300.0 mm
