Harrishao/mechanic-design/交付用/三维模型/d25传动轴.SLDPRT

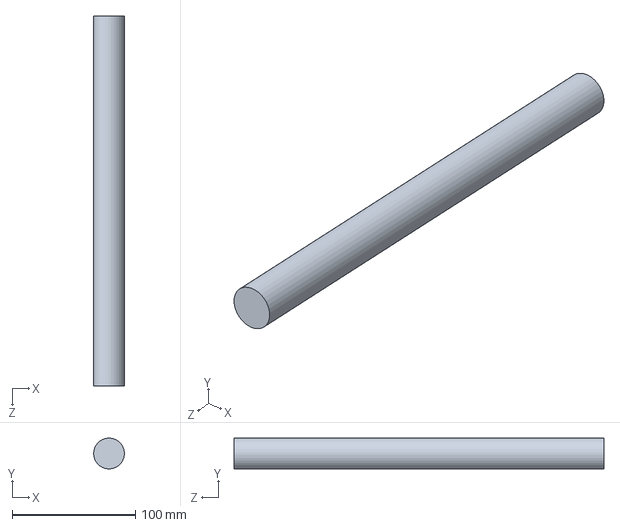
[picture p48: CAD file, 2026-06-14]
交付用/三维模型/d25传动轴.SLDPRT
25.0 x 25.0 x 300.0 mm
