Harrishao/mechanic-design/三维模型/粉筛托架.SLDPRT

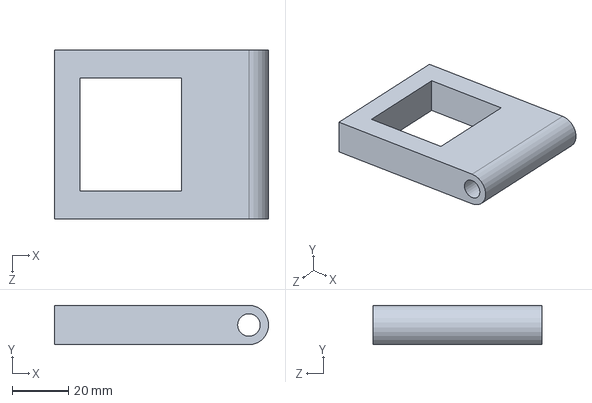
[picture p49: CAD file, 2026-06-11]
三维模型/粉筛托架.SLDPRT
75.9 x 14.0 x 60.0 mm
