Harrishao/mechanic-design/交付用/三维模型/上冲头下摆杆v2.SLDPRT

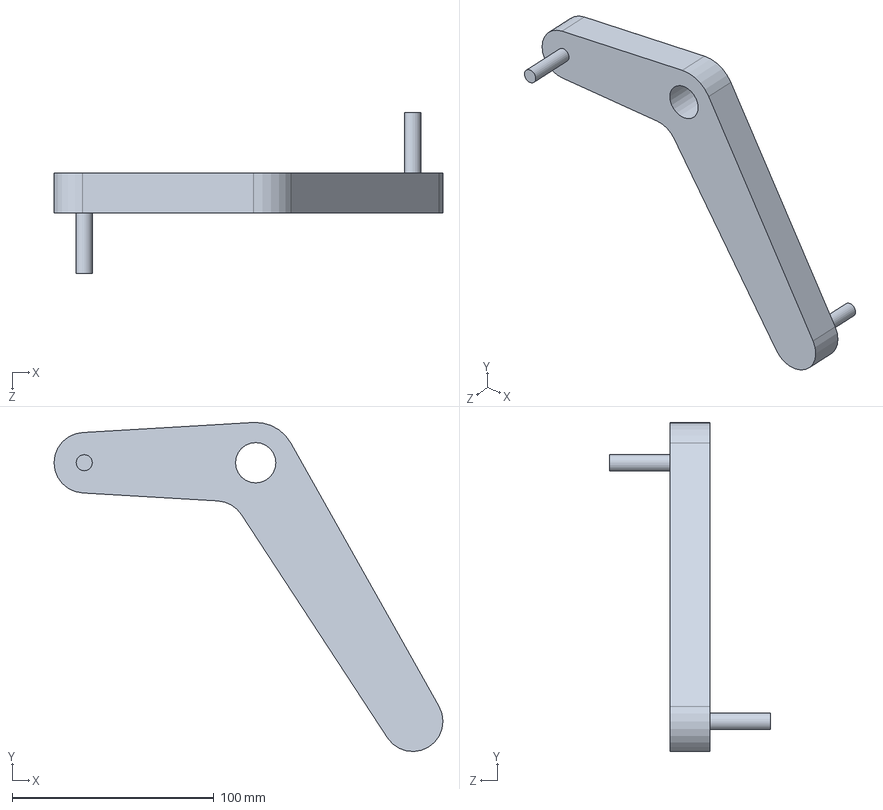
[picture p50: CAD file, 2026-06-14]
交付用/三维模型/上冲头下摆杆v2.SLDPRT
192.9 x 163.2 x 80.0 mm
