Harrishao/mechanic-design/交付用/三维模型/齿轮z1.SLDPRT

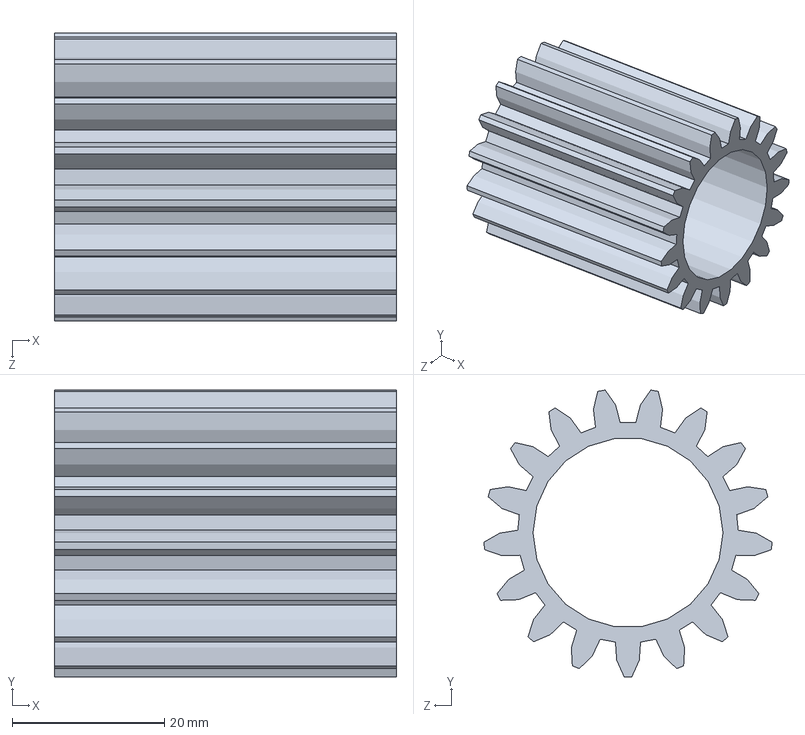
[picture p51: CAD file, 2026-06-14]
交付用/三维模型/齿轮z1.SLDPRT
45.0 x 37.8 x 37.9 mm
