Harrishao/mechanic-design/交付用/三维模型/下冲头.SLDPRT

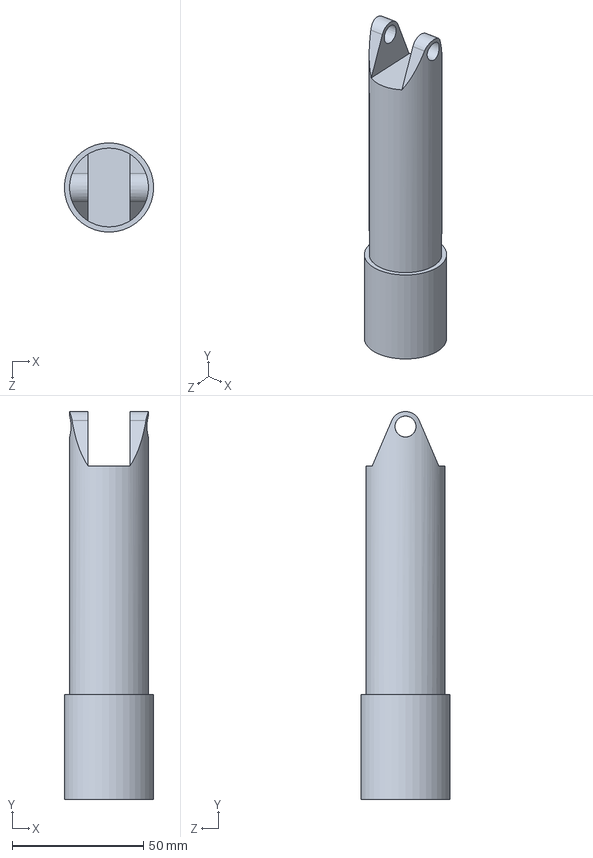
[picture p52: CAD file, 2026-06-14]
交付用/三维模型/下冲头.SLDPRT
34.0 x 147.7 x 34.0 mm
