Harrishao/mechanic-design/三维模型/上冲头凸轮.SLDPRT

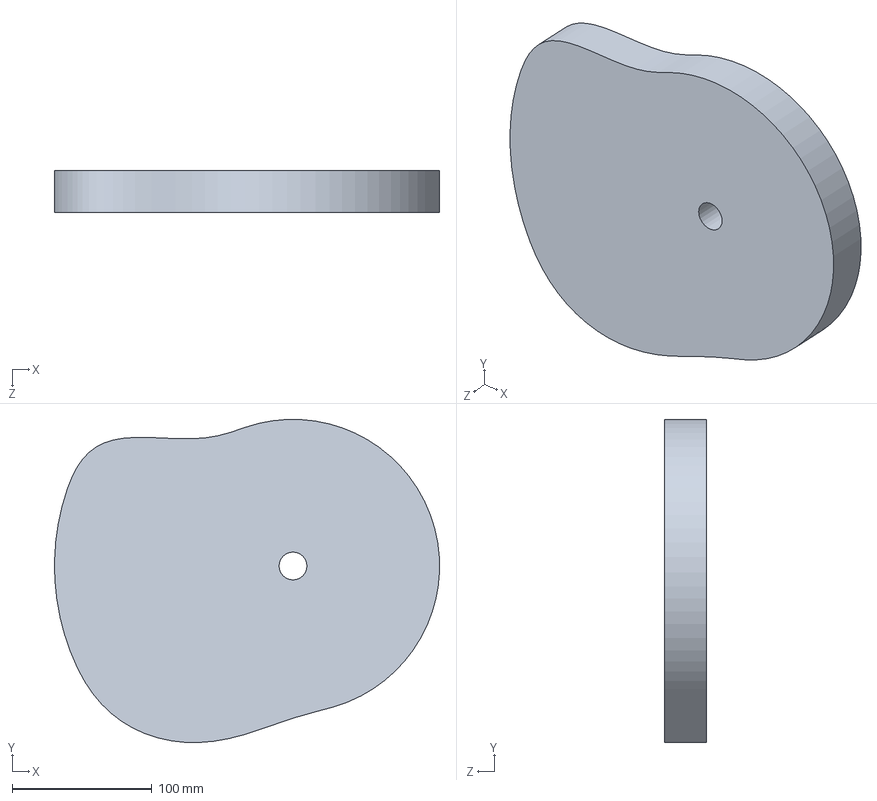
[picture p53: CAD file, 2026-06-11]
三维模型/上冲头凸轮.SLDPRT
275.9 x 231.5 x 30.0 mm
