Harrishao/mechanic-design/交付用/三维模型/齿轮z4.SLDPRT

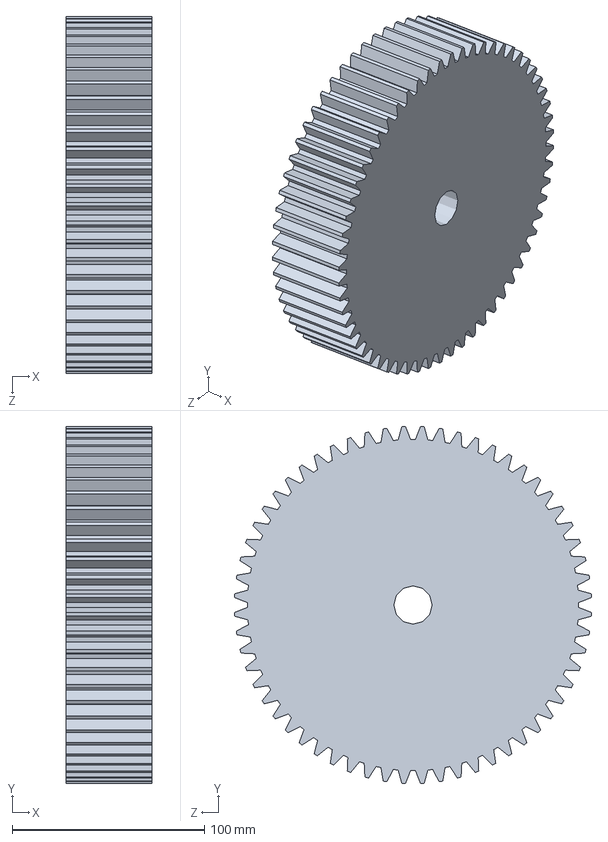
[picture p55: CAD file, 2026-06-14]
交付用/三维模型/齿轮z4.SLDPRT
45.0 x 185.8 x 185.8 mm
