Harrishao/mechanic-design/交付用/三维模型/飞轮.SLDPRT

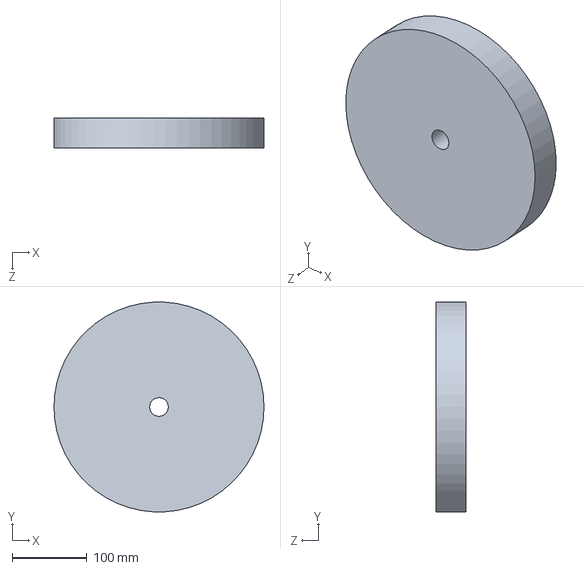
[picture p56: CAD file, 2026-06-14]
交付用/三维模型/飞轮.SLDPRT
280.0 x 279.5 x 40.0 mm
