Harrishao/mechanic-design/三维模型/上冲头.SLDPRT

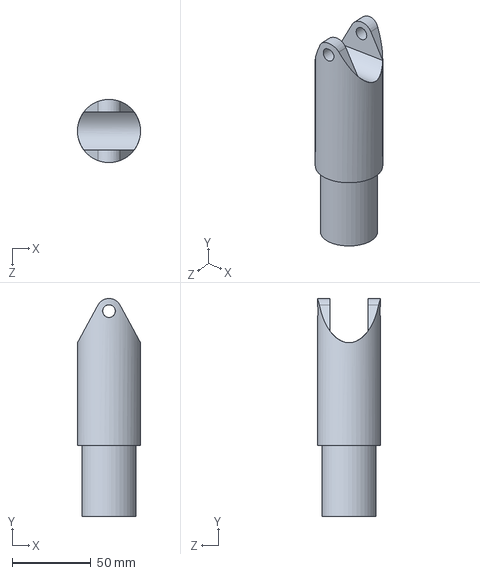
[picture p58: CAD file, 2026-06-11]
三维模型/上冲头.SLDPRT
40.0 x 138.0 x 40.0 mm
