Harrishao/mechanic-design/交付用/三维模型/小带轮.SLDPRT

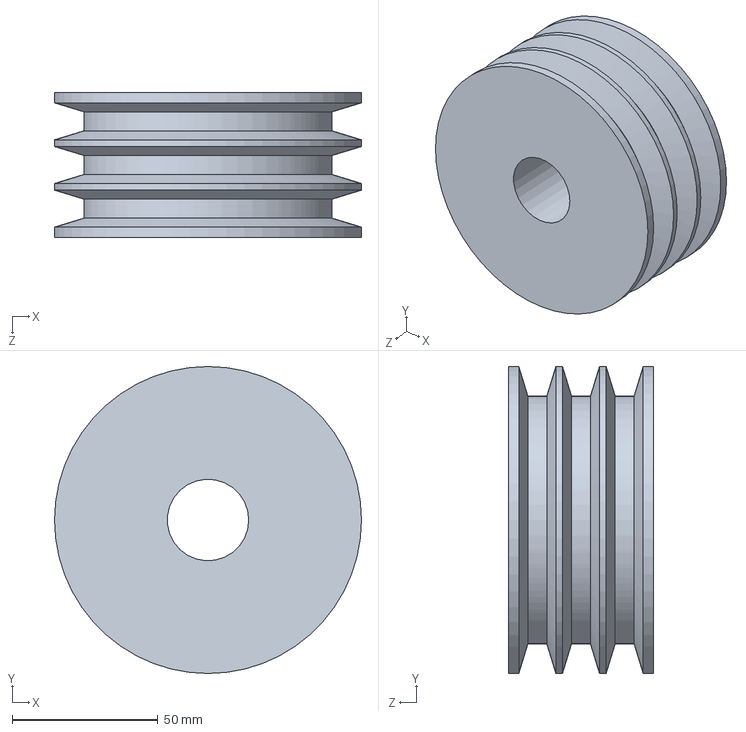
[picture p59: CAD file, 2026-06-14]
交付用/三维模型/小带轮.SLDPRT
105.5 x 105.5 x 50.0 mm
