Harrishao/mechanic-design/三维模型/上冲头摆杆-z轴避让fix.SLDPRT

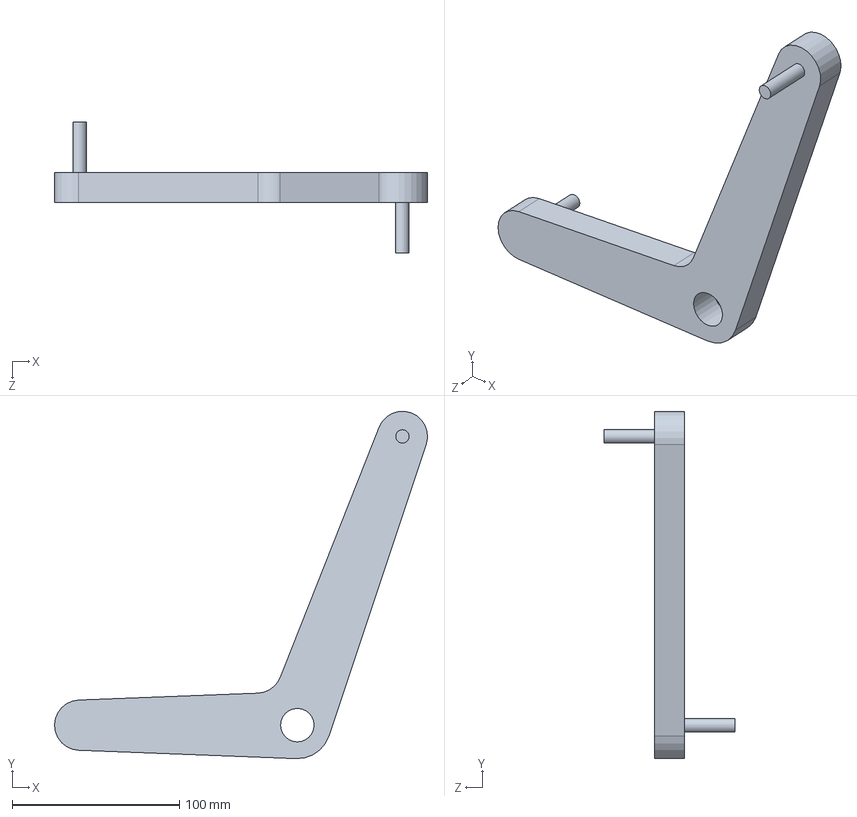
[picture p60: CAD file, 2026-06-11]
三维模型/上冲头摆杆-z轴避让fix.SLDPRT
222.7 x 207.4 x 78.0 mm
