Harrishao/mechanic-design/交付用/三维模型/齿轮z2.SLDPRT

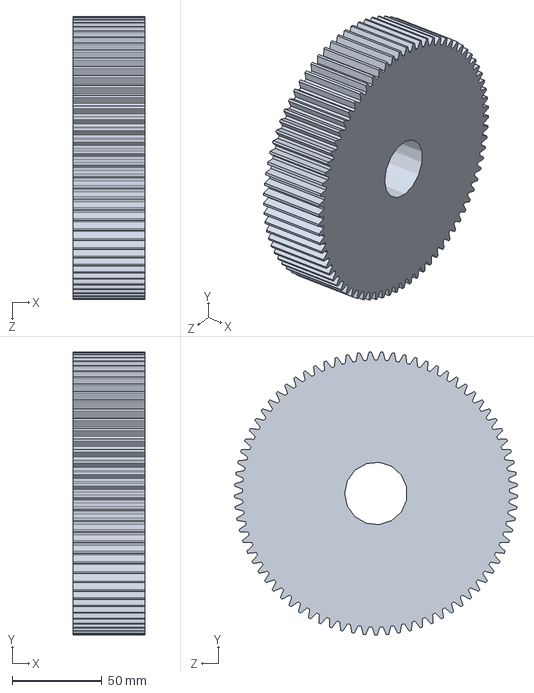
[picture p61: CAD file, 2026-06-14]
交付用/三维模型/齿轮z2.SLDPRT
40.0 x 158.0 x 158.0 mm
