Harrishao/mechanic-design/交付用/三维模型/粉筛凸轮v4.SLDPRT

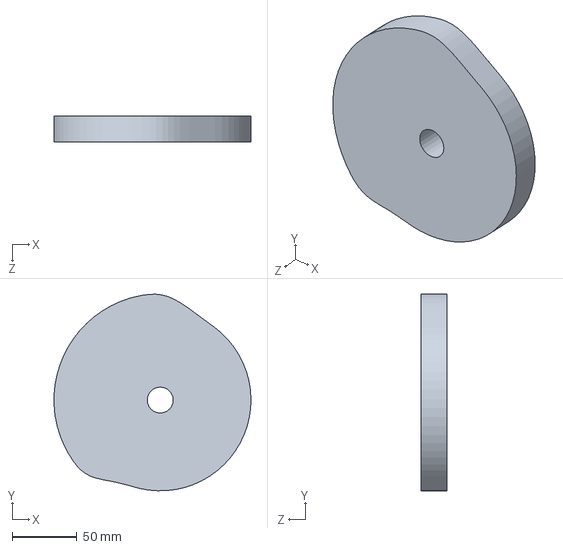
[picture p62: CAD file, 2026-06-12]
交付用/三维模型/粉筛凸轮v4.SLDPRT
151.9 x 151.6 x 20.0 mm
