Harrishao/mechanic-design/交付用/三维模型/粉筛托架v4.SLDPRT

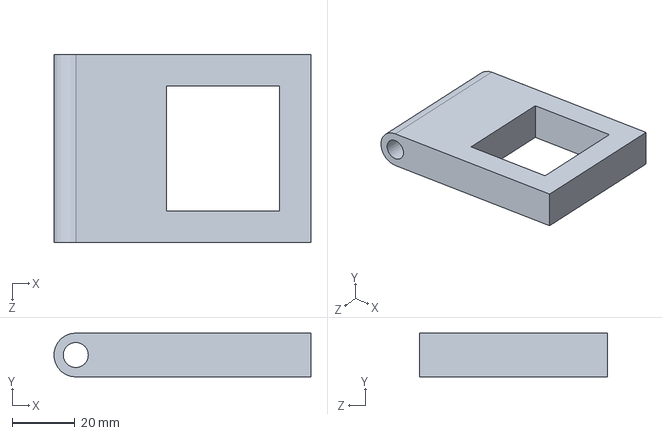
[picture p63: CAD file, 2026-06-12]
交付用/三维模型/粉筛托架v4.SLDPRT
81.9 x 14.0 x 60.0 mm
