Harrishao/mechanic-design/三维模型/上冲头摆杆.SLDPRT

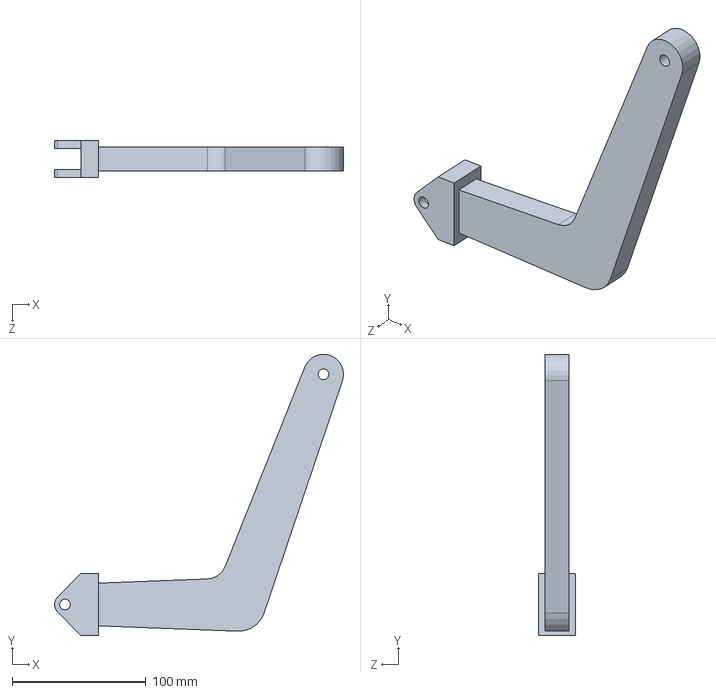
[picture p64: CAD file, 2026-06-07]
三维模型/上冲头摆杆.SLDPRT
216.2 x 210.5 x 28.0 mm
