Harrishao/mechanic-design/交付用/三维模型/粉筛摆杆v4.SLDPRT

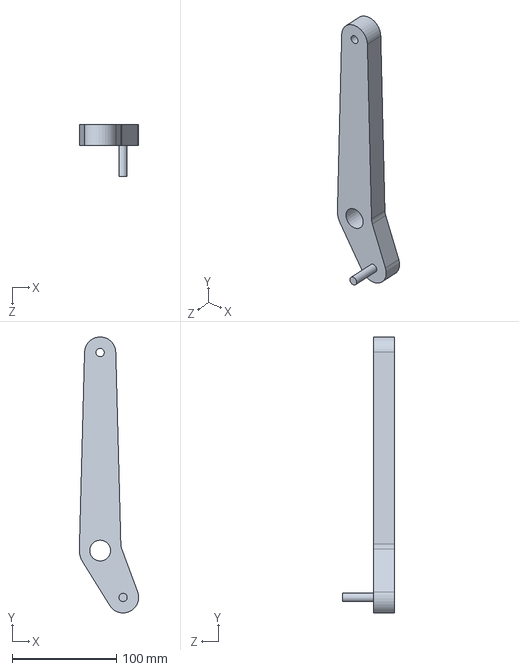
[picture p65: CAD file, 2026-06-12]
交付用/三维模型/粉筛摆杆v4.SLDPRT
57.0 x 264.8 x 50.0 mm
