Harrishao/mechanic-design/交付用/三维模型/粉筛连杆v4.SLDPRT

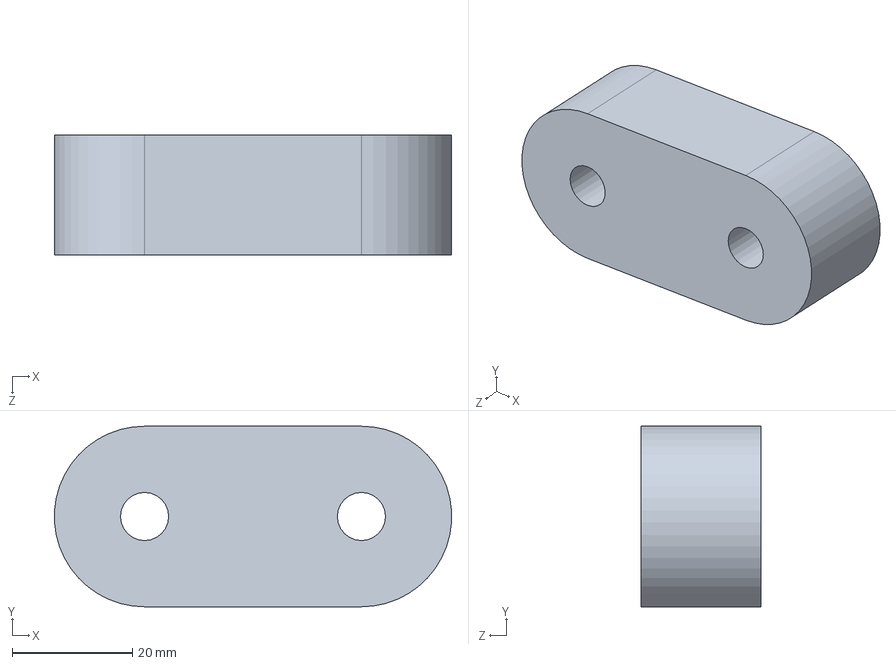
[picture p66: CAD file, 2026-06-12]
交付用/三维模型/粉筛连杆v4.SLDPRT
66.0 x 30.0 x 20.0 mm
