Harrishao/mechanic-design/交付用/三维模型/上冲头长连杆v2.SLDPRT

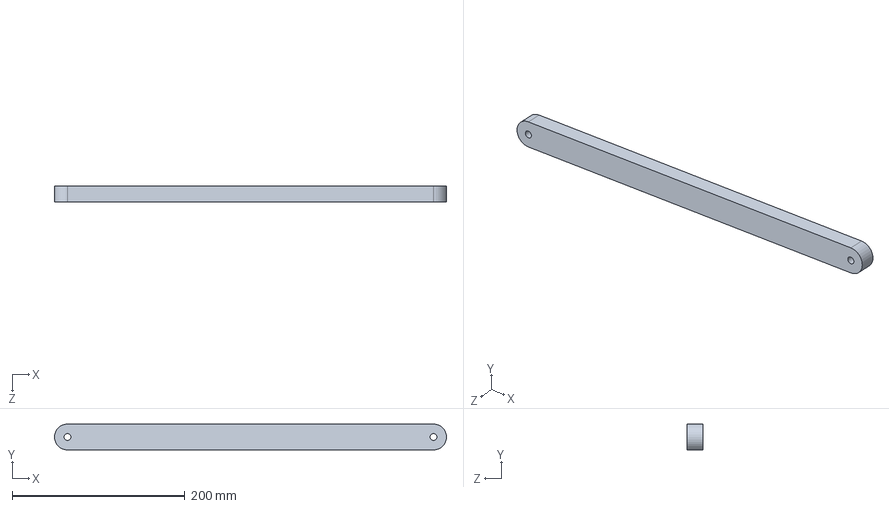
[picture p67: CAD file, 2026-06-11]
交付用/三维模型/上冲头长连杆v2.SLDPRT
453.9 x 30.0 x 18.0 mm
