Harrishao/mechanic-design/交付用/三维模型/粉筛滑块.SLDPRT

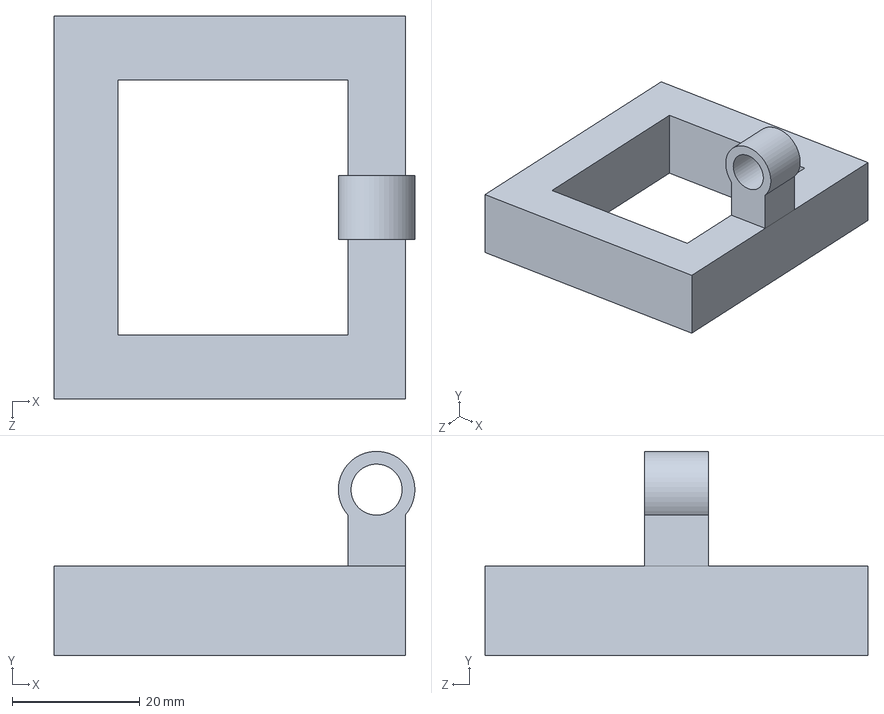
[picture p68: CAD file, 2026-06-11]
交付用/三维模型/粉筛滑块.SLDPRT
56.5 x 32.0 x 60.0 mm
