Harrishao/mechanic-design/交付用/三维模型/d8销l40.SLDPRT

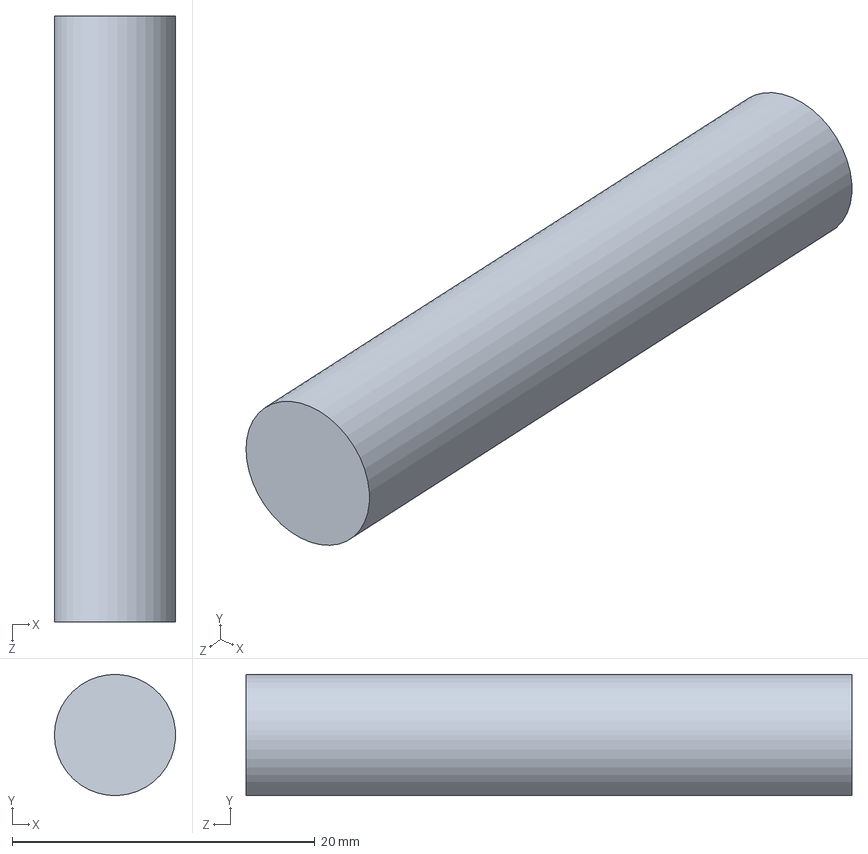
[picture p69: CAD file, 2026-06-11]
交付用/三维模型/d8销l40.SLDPRT
8.00 x 7.99 x 40.0 mm
