Harrishao/mechanic-design/交付用/三维模型/导向套.SLDPRT

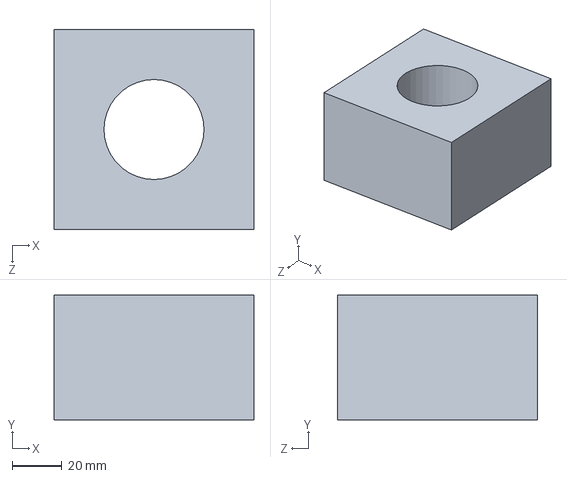
[picture p70: CAD file, 2026-06-11]
交付用/三维模型/导向套.SLDPRT
80.0 x 50.0 x 80.0 mm
