Harrishao/mechanic-design/交付用/三维模型/d20销.SLDPRT

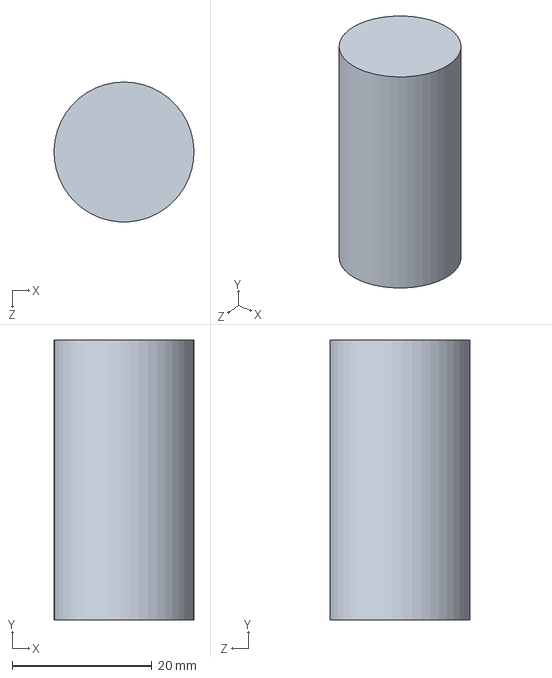
[picture p71: CAD file, 2026-06-11]
交付用/三维模型/d20销.SLDPRT
20.0 x 40.0 x 20.0 mm
