Harrishao/mechanic-design/交付用/三维模型/d8销l80.SLDPRT

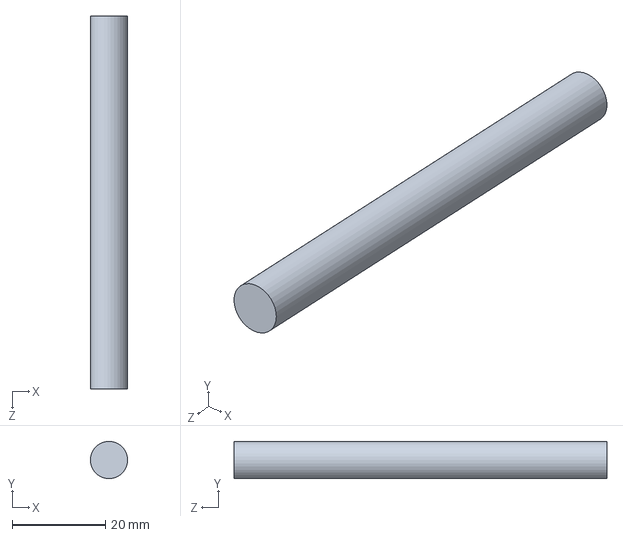
[picture p72: CAD file, 2026-06-11]
交付用/三维模型/d8销l80.SLDPRT
8.00 x 7.97 x 80.0 mm
