Harrishao/mechanic-design/交付用/三维模型/粉筛滚子.SLDPRT

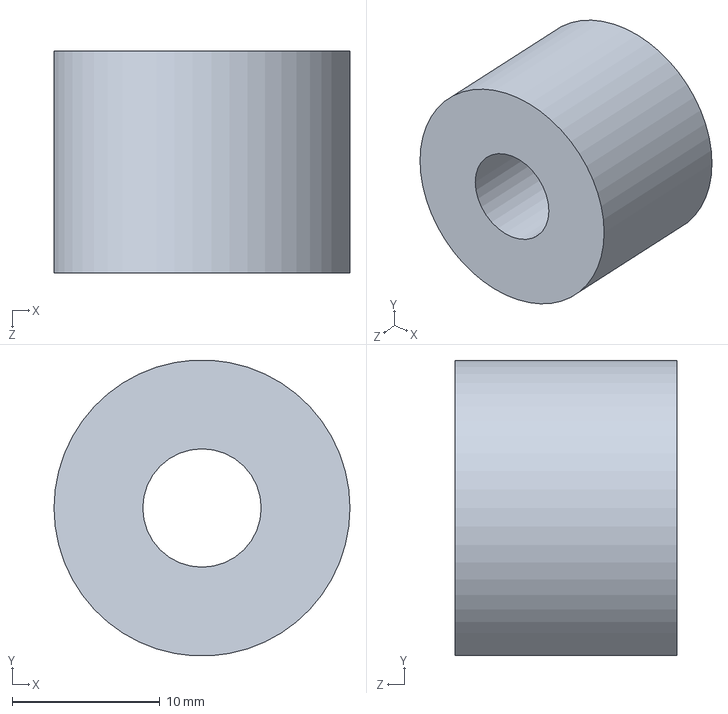
[picture p73: CAD file, 2026-06-11]
交付用/三维模型/粉筛滚子.SLDPRT
20.0 x 20.0 x 15.0 mm
