Harrishao/mechanic-design/交付用/三维模型/型腔.SLDPRT

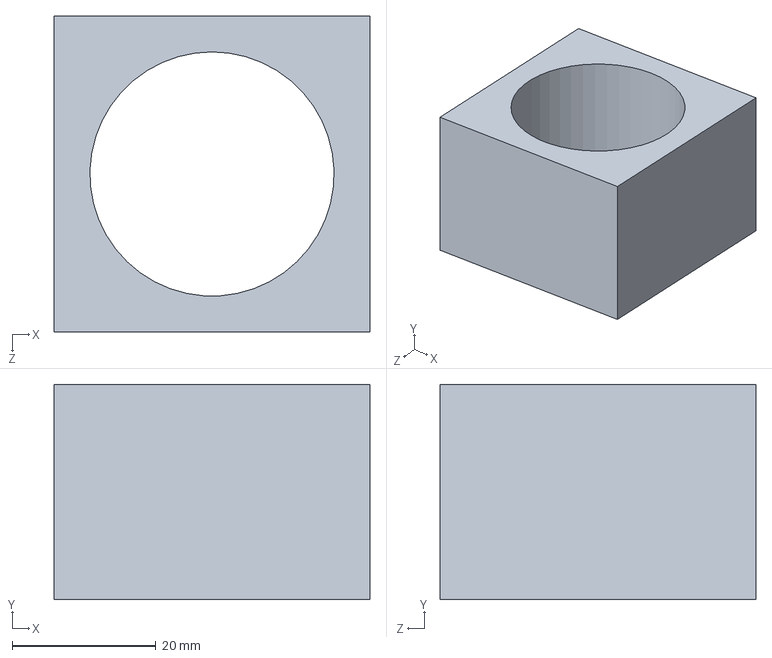
[picture p74: CAD file, 2026-06-11]
交付用/三维模型/型腔.SLDPRT
44.0 x 30.0 x 44.0 mm
