Harrishao/mechanic-design/交付用/三维模型/上冲头凸轮v2.SLDPRT

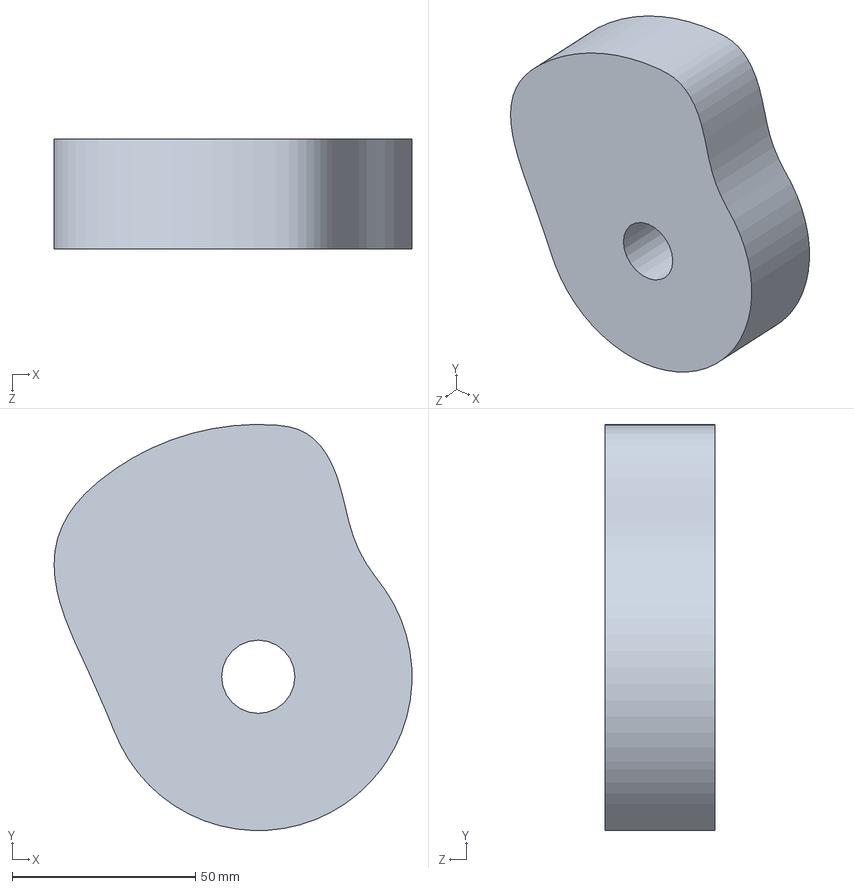
[picture p75: CAD file, 2026-06-11]
交付用/三维模型/上冲头凸轮v2.SLDPRT
97.7 x 110.9 x 30.0 mm
