Harrishao/mechanic-design/交付用/三维模型/主轴.SLDPRT

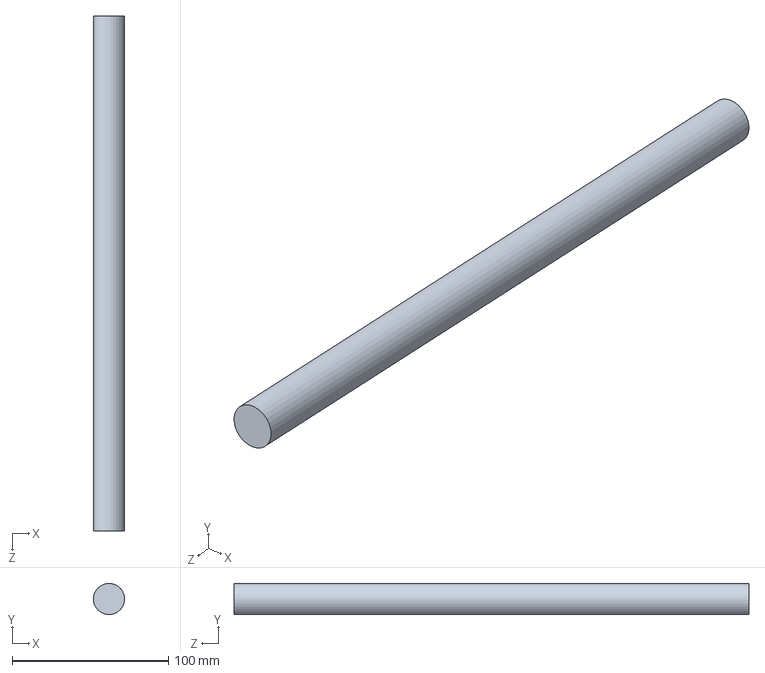
[picture p76: CAD file, 2026-06-11]
交付用/三维模型/主轴.SLDPRT
20.0 x 20.0 x 330.0 mm
