Harrishao/mechanic-design/交付用/三维模型/d8销l22.SLDPRT

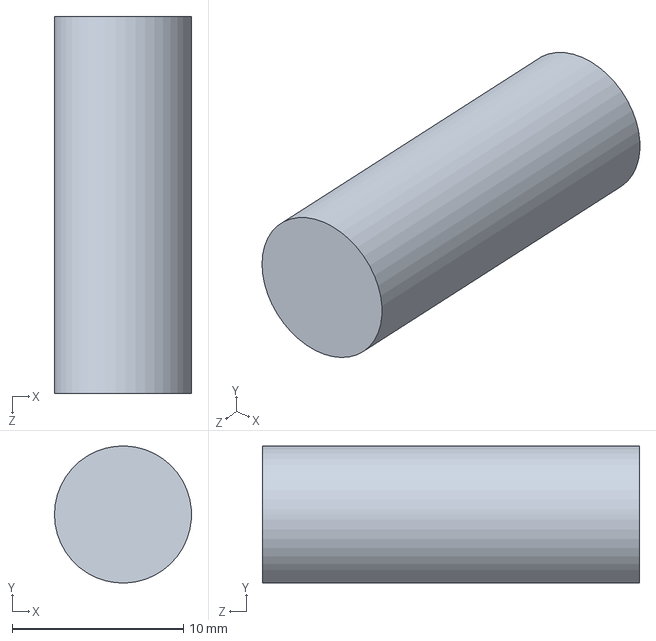
[picture p77: CAD file, 2026-06-11]
交付用/三维模型/d8销l22.SLDPRT
8.00 x 7.99 x 22.0 mm
