Harrishao/mechanic-design/交付用/三维模型/上冲头短连杆v2.SLDPRT

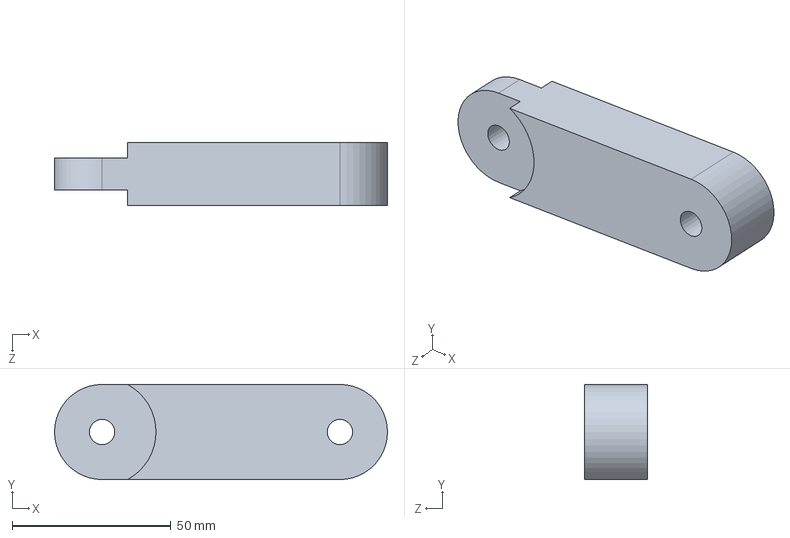
[picture p78: CAD file, 2026-06-11]
交付用/三维模型/上冲头短连杆v2.SLDPRT
105.0 x 30.0 x 20.0 mm
