Harrishao/mechanic-design/交付用/三维模型/上冲头滚子.SLDPRT

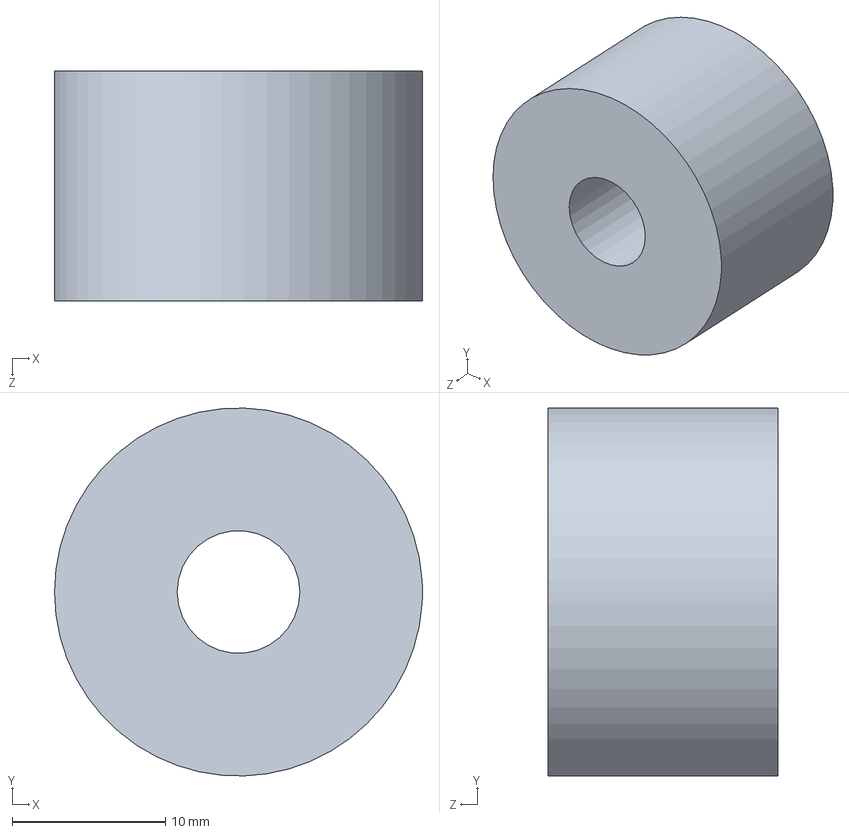
[picture p79: CAD file, 2026-06-11]
交付用/三维模型/上冲头滚子.SLDPRT
24.0 x 24.0 x 15.0 mm
