Harrishao/mechanic-design/交付用/三维模型/d8销l45.SLDPRT

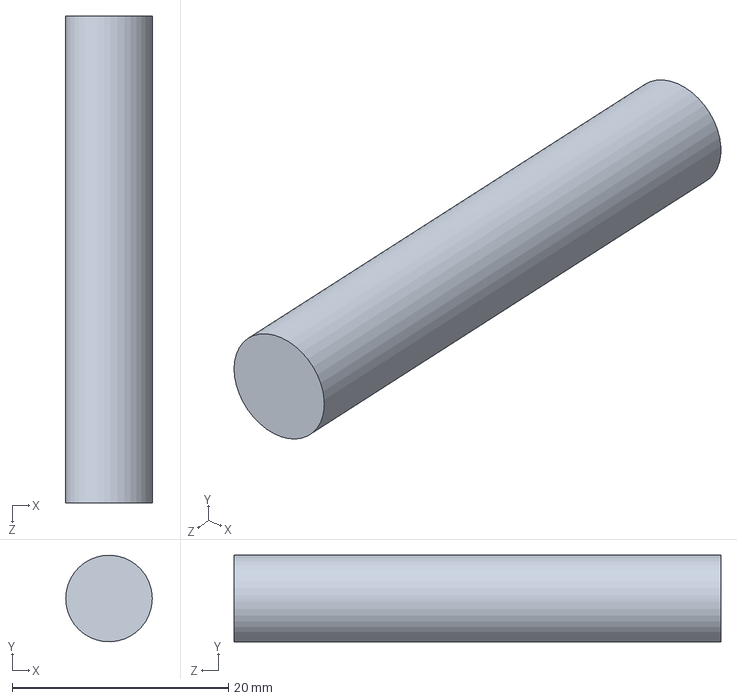
[picture p80: CAD file, 2026-06-11]
交付用/三维模型/d8销l45.SLDPRT
8.00 x 7.99 x 45.0 mm
