Harrishao/mechanic-design/交付用/三维模型/d8销.SLDPRT

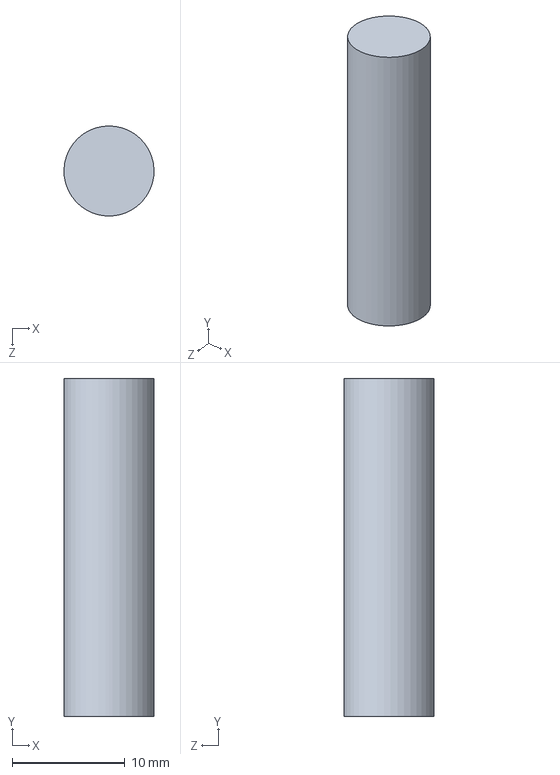
[picture p81: CAD file, 2026-06-07]
交付用/三维模型/d8销.SLDPRT
7.99 x 30.0 x 8.00 mm
