Harrishao/mechanic-design/(list of files, cad)

Other CAD files:
交付用/工程图/上冲头v2.DWG
交付用/工程图/上冲头短连杆v2.DWG
交付用/工程图/上冲头上摆杆v2.DWG
交付用/工程图/粉筛连杆v4.DWG
交付用/工程图/上冲头下摆杆v2.DWG
交付用/工程图/下冲头滚子.DWG
交付用/工程图/粉筛托架v4.DWG
交付用/工程图/粉筛滚子.DWG
交付用/工程图/下冲头.DWG
交付用/工程图/粉筛摆杆v4.DWG
交付用/工程图/下冲头凸轮.DWG
交付用/工程图/上冲头凸轮v2.DWG
交付用/工程图/粉筛凸轮v4.DWG
交付用/工程图/上冲头滚子.DWG
交付用/三维模型/上冲头v2.SLDPRT
交付用/三维模型/下冲头滚子.SLDPRT
三维模型/上冲头摆杆v2-legacy.SLDPRT
三维模型/上冲头摆杆v3-legacy.SLDPRT
三维模型/整机装配.SLDASM
三维模型/粉筛凸轮.SLDPRT
三维模型/粉筛凸轮v2.SLDPRT
三维模型/粉筛摆杆.SLDPRT
三维模型/粉筛摆杆v2.SLDPRT
三维模型/粉筛连杆v2.SLDPRT
交付用/三维模型/IE3 Electric Motor 112l 6p B3/5561120109.SLDASM
交付用/三维模型/IE3 Electric Motor 112l 6p B3/5561120109_01.SLDPRT
交付用/三维模型/IE3 Electric Motor 112l 6p B3/5561120109_02.SLDPRT
交付用/三维模型/IE3 Electric Motor 112l 6p B3/5561120109_03.SLDPRT
交付用/三维模型/IE3 Electric Motor 112l 6p B3/5561120109_04.SLDPRT
交付用/三维模型/IE3 Electric Motor 112l 6p B3/5561120109_05.SLDPRT
交付用/三维模型/IE3 Electric Motor 112l 6p B3/5561120109_06.SLDPRT
交付用/三维模型/IE3 Electric Motor 112l 6p B3/5561120109_07.SLDPRT
交付用/三维模型/IE3 Electric Motor 112l 6p B3/5561120109_08.SLDPRT
交付用/三维模型/IE3 Electric Motor 112l 6p B3/5561120109_09.SLDPRT
交付用/三维模型/IE3 Electric Motor 112l 6p B3/5561120109_10.SLDPRT
交付用/三维模型/IE3 Electric Motor 112l 6p B3/5561120109_11.SLDPRT
交付用/三维模型/IE3 Electric Motor 112l 6p B3/5561120109_12.SLDPRT
交付用/三维模型/IE3 Electric Motor 112l 6p B3/5561120109_13.SLDPRT
交付用/三维模型/IE3 Electric Motor 112l 6p B3/5561120109_14.SLDPRT
交付用/三维模型/IE3 Electric Motor 112l 6p B3/5561120109_15.SLDPRT
交付用/三维模型/IE3 Electric Motor 112l 6p B3/5561120109_16.SLDPRT
交付用/三维模型/IE3 Electric Motor 112l 6p B3/5561120109_17.SLDPRT
交付用/三维模型/IE3 Electric Motor 112l 6p B3/5561120109_18.SLDPRT
交付用/三维模型/IE3 Electric Motor 112l 6p B3/5561120109_19.SLDPRT
交付用/三维模型/IE3 Electric Motor 112l 6p B3/5561120109_20.SLDPRT
交付用/三维模型/IE3 Electric Motor 112l 6p B3/5561120109_21.SLDPRT
交付用/三维模型/IE3 Electric Motor 112l 6p B3/5561120109_22.SLDPRT
交付用/三维模型/IE3 Electric Motor 112l 6p B3/5561120109_23.SLDPRT
交付用/三维模型/IE3 Electric Motor 112l 6p B3/5561120109_24.SLDPRT
交付用/三维模型/IE3 Electric Motor 112l 6p B3/5561120109_25.SLDPRT
交付用/三维模型/IE3 Electric Motor 112l 6p B3/5561120109_26.SLDPRT
交付用/三维模型/IE3 Electric Motor 112l 6p B3/5561120109_27.SLDPRT
交付用/三维模型/IE3 Electric Motor 112l 6p B3/5561120109_28.SLDPRT
交付用/三维模型/IE3 Electric Motor 112l 6p B3/5561120109_29.SLDPRT
交付用/三维模型/IE3 Electric Motor 112l 6p B3/5561120109_30.SLDPRT
交付用/三维模型/IE3 Electric Motor 112l 6p B3/5561120109_31.SLDPRT
交付用/三维模型/IE3 Electric Motor 112l 6p B3/5561120109_32.SLDPRT
交付用/三维模型/IE3 Electric Motor 112l 6p B3/5561120109_33.SLDPRT
交付用/三维模型/IE3 Electric Motor 112l 6p B3/5561120109_34.SLDPRT
交付用/三维模型/IE3 Electric Motor 112l 6p B3/5561120109_35.SLDPRT
交付用/三维模型/IE3 Electric Motor 112l 6p B3/5561120109_36.SLDPRT
交付用/三维模型/IE3 Electric Motor 112l 6p B3/5561120109_37.SLDPRT
交付用/三维模型/IE3 Electric Motor 112l 6p B3/5561120109_38.SLDPRT
交付用/三维模型/IE3 Electric Motor 112l 6p B3/5561120109_39.SLDPRT
交付用/三维模型/IE3 Electric Motor 112l 6p B3/5561120109_40.SLDPRT
交付用/三维模型/IE3 Electric Motor 112l 6p B3/5561120109_41.SLDPRT
交付用/三维模型/IE3 Electric Motor 112l 6p B3/5561120109_42.SLDPRT
交付用/三维模型/IE3 Electric Motor 112l 6p B3/5561120109_43.SLDPRT
交付用/三维模型/IE3 Electric Motor 112l 6p B3/5561120109_44.SLDPRT
交付用/三维模型/IE3 Electric Motor 112l 6p B3/5561120109_45.SLDPRT
交付用/三维模型/IE3 Electric Motor 112l 6p B3/5561120109_46.SLDPRT
交付用/三维模型/IE3 Electric Motor 112l 6p B3/5561120109_47.SLDPRT
交付用/三维模型/IE3 Electric Motor 112l 6p B3/5561120109_48.SLDPRT
交付用/三维模型/IE3 Electric Motor 112l 6p B3/5561120109_49.SLDPRT
交付用/三维模型/IE3 Electric Motor 112l 6p B3/5561120109_50.SLDPRT
交付用/三维模型/IE3 Electric Motor 112l 6p B3/5561120109_51.SLDPRT
交付用/三维模型/IE3 Electric Motor 112l 6p B3/5561120109_52.SLDPRT
交付用/三维模型/IE3 Electric Motor 112l 6p B3/5561120109_53.SLDPRT
交付用/三维模型/IE3 Electric Motor 112l 6p B3/5561120109_54.SLDPRT
交付用/三维模型/IE3 Electric Motor 112l 6p B3/5561120109_55.SLDPRT
