Harrishao/mechanic-design/设计文档/整机装配参数填写表.md

# 15吨压片机 整机装配参数填写表

> 用法：按你**实际建模**的数值填写每个空格（`______`）。带「待建」的件请先补建再填。填完后交给小克，据此计算三凸轮相位、轴向站位与各支点坐标，进入整机装配。
> 参考数值可对照 `设计文档/15吨压片机构件尺寸设计.docx`，但以你的实际模型为准。

---

## 0. 装配基准约定（先确定，后面都以此为参照）

- 主轴轴线方向（建议沿 Z，水平）：Z轴
- 凸轮回转中心 O1 位置：(0,0,0)（建议放装配体原点）
- 型腔轴线（竖直中线）所在 X：X = 0（建议 X = 0，过 O1）
- 三机构所在前视平面（XY）法向 = 主轴方向（Z）：确认 □ 确认

---

## 1. 主轴与三凸轮安装【主轴待建】

主轴：
- 配凸轮处轴径（= 凸轮轴孔径）= 20 mm
- 主轴总长 = 330_ mm
- 相位基准（键槽/平面）方位 = +Y（竖直向上）作为主轴 0°；键槽/基准平面朝 +Y。（注：这是绕轴线的"零度刻度"，不是主轴方向；主轴方向已是 Z 轴）

三凸轮**轴向站位**（沿主轴，各凸轮中面的 Z 坐标）：
- 下冲头凸轮 中面 Z = 0 mm
- 上冲头凸轮 中面 Z = 67.5 mm
- 粉筛凸轮 中面 Z = 132.5 mm
- 相邻凸轮净间隙（含避让让位）= 40 mm

三凸轮轮缘宽：下冲头 25 / 上冲头 30 / 粉筛 20 mm

三凸轮**安装相位**（决定三机构协调）：
- 推荐用"装填位对齐法"：把主轴置于 0°基准，再将每个凸轮各自旋转到使本机构恰处装填位姿态（下冲头在装填位、上冲头在最高近休、粉筛在型腔上方），然后固定到轴上。三条廓线由同一主轴角生成，此法自动满足相位，无需逐个算角度。
- 以下冲头凸轮为 0°参考（其 φ=0 廓线基准朝 +Y）。
- 数值安装角（把导入廓线绕凸轮中心 O1 旋转此角后装到主轴；等于各机构相对 synth 基准的整体旋转角 = 各自 O2 方位角）：**下冲头 0°、上冲头 128°、粉筛 201°**。与"装填位对齐法"等效，二选一即可。

---

## 2. 下冲头机构

- 凸轮理论基圆 r0 = 50 mm 实际基圆 = 40 mm
- 滚子直径 = 20 mm 宽 = 15 mm
- 下冲头工作端 φ = 34 mm 导向段 φ = 30 mm
- 下冲头总长（尖端 → 滚子中心）= 142 mm
- 装填位时滚子中心距凸轮中心 = 53 mm（= 理论基圆 50 + 装填升程 3）
- 下冲头轴线 X = 0（应与型腔轴线一致）

---

## 3. 上冲头机构

- 选用的摆杆版本（摆杆 / z轴避让fix / v2 / v3）：z轴避让fix
- 凸轮理论基圆 r0 = 117 mm
- 中心距 a（O1 → 摆杆支点 O2）= 175 mm
- 摆杆滚子臂 Lr（O2 → 滚子）= 130 mm
- 摆杆连杆臂 Rb（O2 → 铰点 B）= 183.5 mm
- 两臂夹角 ∠P-O2-B = 110°
- 摆杆基位角 γ0 = 42° 最大摆角 ψmax = 30°
- 连杆长（B → C 孔心距）= 350 mm
- 滑块行程 = 95 mm 工作端 φ = 34 mm 导向 φ = 40 mm
- 冲头销 C → 尖端长度 Lp = 231 mm（θ=128°下滑块销 C 保压位 Y=436，尖端到 Y=205 压到型腔，故 Lp=436−205≈231。已弃用原 182）
- z轴避让：摆杆本体轴向偏置量 = ______ mm 滚子悬臂伸出量 = ______ mm
  - 此项应该不影响xy平面内的机构运动，根据实际情况再调整
- 滚子直径 = 24 mm 宽 = 15 mm
- 摆杆支点 O2 坐标（X,Y）= (−108, 138)（方位角 θ=128°；该方位下滑块行程=95.3mm 达标。注：之前 (108,138)/θ=52° 是镜像错误分支，已按真实节曲线修正到 −X 侧）

---

## 4. 粉筛机构

- 摆杆是否已做 z轴避让：是（是，偏置量后续调整）
- 凸轮理论基圆 r0 = 113.5 mm
- 中心距 a（O1 → O2）= 170 mm
- 摆杆滚子臂 Lr = 90 mm 连杆臂 Rb = 110.9 mm 两臂夹角 = 120°
- 摆杆基位角 γ0 = 38° 最大摆角 ψmax = 25°
- 连杆长 = 250 mm
- 托架：运动方向长 = 55 mm 宽 = 60 mm 厚 = 14 mm
- 筛口尺寸（运动向 × 横向）= 36 × 40 mm
- 筛口近边距推卸前缘 = 10 mm
- 耳板销孔轴心距托架上表面 = 12 mm（向上为正/向下为负）
- 托架水平行程 = 48 mm
- 滚子直径 = 20 mm 宽 = 15 mm
- 摆杆支点 O2 坐标（X,Y）= (−159, −61)（方位角 θ=201°；该方位下托架水平行程=48.4mm，装料位托架销 X≈+42，把筛口中心标到 X=0 即正对型腔。托架销在台面上方 Y≈223）

---

## 5. 型腔（上、下冲头与粉筛共用）

- 型腔高 = 30 mm（本表按 30）孔径（配冲头）φ = 34 mm
- 型腔上表面 Y = 216 mm 下表面 Y = 186 mm（由下冲头反推：滚子中心 53 + 下冲头长 142 + 顶出 21 = 216；下表面 = 216 − 30）
- 型腔轴线 X = 0（应 = 中线）
  - 一致性核对：上冲头保压时尖端应到 Y=205（型腔顶下 11），故滑块销 C 保压位 Y=205+Lp(182)=387、装填位 Y=387+95=482；据此摆放上冲头滑块导向线高度

---

## 6. 销

- 该部分暂不考虑z轴长度，后续再为销孔定制，默认认为与销孔两端平齐
  - d20销：直径 20
  - d8销：直径 8

---

## 7. 传动件【待建，若整机含传动则填】

- V带轮：小带轮 dd1 = ______ 大带轮 dd2 = ______ mm 中心距 = ______ mm
- 齿轮一级：m = ______ z1 = ______ z2 = ______ 中心距 = ______ mm
- 齿轮二级：m = ______ z3 = ______ z4 = ______ 中心距 = ______ mm
- 飞轮：外径 = ______ 宽 = ______ mm 装于（轴）= ______
- 中间轴 / 电机轴：直径 ______ / ______ mm

---

## 待建 / 缺件清单（装配前需补）

- [ ] 主轴（必需，承载三凸轮）
- [ ] 机架 / 导向套 / 轴承座（固定各支点、导向冲头、支承主轴与中间轴）
- [ ] 传动件：带轮×2、齿轮×4、飞轮、中间轴（若整机含传动）
- [ ] 指定上冲头最终摆杆版本，删除多余版本

---

## 填完后小克将据此计算并交付

- 三凸轮相对安装相位（按运动循环图）
- 三凸轮轴向站位与避让间隙核对
- 各摆杆支点 O2、滑块/托架导向线、型腔的装配坐标
- 整机装配配合清单与干涉检查要点
