Harrishao/mechanic-design/(commit log)

2026-06-06 はわわわ…
2026-06-07 0607更新
    [d20销.SLDPRT, d8销.SLDPRT, 上冲头凸轮.SLDPRT, 上冲头凸轮.csv, 上冲头摆杆.SLDPRT, 上冲头滚子.SLDPRT, 下冲头.SLDPRT, 下冲头凸轮.SLDPRT]
2026-06-07 一些更新
    [上冲头连杆.SLDPRT]
2026-06-11 0611-重做机构
    [d20销.SLDPRT, d8销l22.SLDPRT, d8销l40.SLDPRT, d8销l45.SLDPRT, d8销l80.SLDPRT, 上冲头.SLDPRT, 上冲头v2.SLDPRT, 上冲头上摆杆v2.SLDPRT]
2026-06-11 0611-运动验证通过
    [整机装配v2.SLDASM, 粉筛凸轮v2.SLDPRT, 粉筛凸轮v3.csv, 粉筛托架.SLDPRT, 粉筛摆杆v2.SLDPRT, 粉筛连杆v2.SLDPRT]
